dditsupport/solar_monitor/README.md

# Solar AC-Side Power Monitor

Single-phase AC-side monitoring for a 3.3 kW rooftop solar installation. The
device measures inverter output with a PZEM-004T v3.0, displays live metrics
on a local OLED, buffers 15-minute readings to internal flash, and mirrors
them to a MilesWeb-hosted PHP/MySQL backend via two store-and-forward paths:

- **Wi-Fi** — when a known hotspot is in range, the ESP32 connects, NTP-syncs,
  POSTs buffered rows, and clears them on server ACK.
- **BLE** — a companion Android app pulls buffered rows over GATT and
  forwards them to the same MilesWeb endpoint over the phone's cellular
  data.

The ESP32 is the source of truth. Cloud and app are catch-up mirrors.

## Repository layout

```
firmware/                 ESP32 firmware — three Arduino sketch variants
                          (see "Firmware variants" below)
backend/                  MilesWeb PHP + MySQL (planned, not yet built)
android/                  Companion app (planned, not yet built)
docs/                     Wiring, provisioning, future hardware notes
tools/                    Bench-test helpers (fake_ingest.py)
```

## How fast does data reach the cloud?

The firmware aims for **seconds, not minutes**, when Wi-Fi is reachable.
Once a 15-minute row is appended to flash, the sampling task immediately
asks the connectivity task to run a Wi-Fi cycle; the next 1-second tick
picks it up, connects, NTP-syncs, POSTs, and (on ACK) truncates the row
from flash. The 2-minute periodic scan still runs as a fallback for when
the AP is out of range.

If neither the RTC nor NTP gave the device a wall clock, the firmware
still POSTs (`sync_wall_time` is empty); MilesWeb is expected to return a
`server_time` ISO 8601 string in the response. The firmware uses that to
seed its clock and the RTC, so subsequent rows carry real timestamps.

## Status

This branch delivers **firmware Stages 1–7** per the project spec:

| Stage | Scope | Status |
|---|---|---|
| 1 | OLED bring-up | ✅ |
| 2 | PZEM bring-up | ✅ |
| 3 | PZEM + OLED integration | ✅ |
| 4 | LittleFS + NVS + boot history | ✅ |
| 5 | Backend (MilesWeb) | ⏳ next session |
| 6 | Wi-Fi sync end-to-end | ✅ (testable against `tools/fake_ingest.py`) |
| 7 | BLE GATT service | ✅ (testable with nRF Connect) |
| 8 | Android companion app | ⏳ next session |
| 9 | Backend dashboard | ⏳ next session |
| 10 | AC install | hardware, out of code scope |

## Building the firmware

See [`docs/PROVISIONING.md`](docs/PROVISIONING.md) for the full step-by-step.
Quick path:

1. Arduino IDE 2.x with libraries: U8g2, PZEM-004T-v30 (mandulaj),
   ArduinoJson, NimBLE-Arduino, RTClib. A known-good set of all five is
   vendored once at [`firmware/libraries.zip`](firmware/libraries.zip),
   shared by every sketch variant.
2. Board: **ESP32 Dev Module**, partition scheme:
   **No OTA (2MB APP/2MB SPIFFS)** — the build is ~1.5 MB and overflows the
   1.2 MB slot of the default scheme.
3. Open the `.ino` for the variant matching your hardware and Upload.

### Firmware variants

Pick the sketch folder that matches the board you built:

| Variant | Sketch folder | Display | RTC |
|---|---|---|---|
| OLED + DS3231 | `firmware/solar_monitor_SSD1306_ds3231/` | SSD1306 | DS3231 |
| OLED + DS1307 | `firmware/solar_monitor_SSD1306_ds1307/` | SSD1306 | DS1307 |
| Headless + DS1307 | `firmware/solar_monitor_ds1307/` | none | DS1307 |

They share every module except the RTC driver and the display; the two OLED
builds are pin-compatible with each other, while the headless build moves I²C
onto the pins the OLED would use. See [`docs/PINOUT.md`](docs/PINOUT.md).

## Bench-testing without a backend

Run the stub:

```bash
python3 tools/fake_ingest.py --port 8080
```

Point `INGEST_HOST_DEFAULT` in your variant's `firmware/<sketch>/config.h` at
`http://<laptop-ip>:8080/ingest`, reflash, and the device will exercise its
full sync path against the stub.

## Architecture quick reference

- **Two FreeRTOS tasks** pinned to separate cores:
  - Core 0 — sampling: 1 Hz PZEM read + OLED render. Every 15 min appends
    one row to `/log.csv` and advances `last_seq`.
  - Core 1 — connectivity: BLE GATT always advertising. Every 2 min
    attempts the Wi-Fi cycle (scan → connect → NTP → POST → ACK truncate).
- **Single mutex** protects the small shared-state POD; readers snapshot
  a value copy and release before doing any I/O.
- **Monotonic-µs clock** for energy integration (`esp_timer_get_time()`);
  wall-clock is only used for log timestamps and midnight rollover.
- **RTC** (DS3231 or DS1307, depending on variant) on I²C seeds wall-clock
  at boot so "Today: X kWh" is right immediately. NTP corrections are written
  back to the chip so it stays accurate across power loss. If the chip is
  absent or reports lost-power/halted, NTP and BLE Set-Wall-Time still work as
  before. I²C pins differ per variant — see [`docs/PINOUT.md`](docs/PINOUT.md).
- **NVS** uses two namespaces (`cfg` for Wi-Fi credentials, `state` for
  boot id / seq HWM / boot history) and a high-water-mark scheme that
  persists every 10 seqs to limit flash wear at the cost of small
  monotonic gaps across crashes.
- **`/log.csv`** is append-only with crash recovery on boot (deletes any
  leftover `/log.tmp`, validates and trims the last line). Sync uses
  snapshot-and-rewrite: capture max seq from RAM, send rows ≤ that, on
  ACK rewrite the file keeping only rows > that.
- **Buffer full**: when LittleFS free space drops below max(150 KB, 10 %),
  the firmware stops logging and surfaces "BUFFER FULL" on the OLED.

BLE access is gated by an HMAC-SHA256 challenge-response over a pre-shared key
(never sent over the air) — see [`docs/PROVISIONING.md`](docs/PROVISIONING.md)
§3a. Remaining security TODOs (no BLE link encryption, no cert pinning, no
HMAC payload signing on the Wi-Fi POST) are deferred to future hardening.
