dditsupport/solar_monitor/backend/README.md

# Backend (MilesWeb PHP 8.4 + MySQL)

Server-side counterpart to the ESP32 firmware. Multi-device, multi-user
with admin role.

## Host requirements

- **PHP 8.4** (8.2 minimum — `_db.php` exits early below that). Verified
  on 8.4; uses `Random\Randomizer`, `#[\SensitiveParameter]`,
  `JSON_THROW_ON_ERROR`, `match`, `?type`, `never` return, strict types.
- **MySQL 5.7+ or MariaDB 10.3+** (needs `JSON`-free schema and
  `ON DUPLICATE KEY UPDATE` — both old enough).
- **PDO_MYSQL** extension (default on MilesWeb / any cPanel host).
- **`mod_authz_core`** (for the `Require all denied` in `_config/.htaccess`).
  Standard on every Apache 2.4 install.
- **Let's Encrypt / Cloudflare TLS** for the public hostname so the
  ESP32's `WiFiClientSecure::setInsecure()` POST works (we accept any
  cert but still need *some* cert).

No Composer dependencies. No build step. No PHP frameworks.

## Layout

```
backend/
├── schema.sql                       ← one-time SQL setup
└── public_html/                     ← docroot of the solar.aromen.biz subdomain
    ├── _config/
    │   ├── .htaccess                ← Require all denied
    │   ├── secrets.php.example      ← copy to secrets.php, fill in
    │   └── secrets.php              ← gitignored; real creds live here
    ├── api/
    │   ├── _db.php                  ← PDO + auth + helpers
    │   ├── ingest.php               ← device POST endpoint (X-Device-Token)
    │   ├── readings.php             ← GET data for dashboard (session auth)
    │   ├── devices.php              ← list user's devices
    │   ├── login.php                ← POST login (form or JSON)
    │   ├── logout.php
    │   ├── admin_users.php          ← admin user CRUD
    │   └── admin_devices.php        ← admin device CRUD + binding
    ├── dashboard/
    │   ├── login.php                ← sign-in page
    │   ├── index.php                ← user dashboard with charts
    │   └── assets/style.css
    └── admin/
        ├── index.php                ← admin overview + recent ingest log
        ├── users.php                ← create / edit / delete users
        └── devices.php              ← assign devices to users
```

## Deploy

1. **Database** — create a MySQL DB and user in cPanel:
   ```text
   db name:  <prefix>_solar
   db user:  <prefix>_solarapp     (grant ALL on the db)
   ```
   Then in phpMyAdmin → SQL tab, paste the contents of `schema.sql` and run.

2. **Secrets** — copy `public_html/_config/secrets.php.example` to
   `public_html/_config/secrets.php` and fill in DB creds + token.
   The `DEVICE_TOKEN` value must match `DEVICE_TOKEN` in the `config.h` of
   whichever firmware variant you flashed (all sketch folders under
   `firmware/` must carry the same token).

3. **Upload** — drop the contents of `public_html/` into the **solar.aromen.biz**
   subdomain's document root (so the URLs end up at e.g.
   `https://solar.aromen.biz/...`, with no `/solar` path prefix).

4. **Verify .htaccess works** — visit
   `https://solar.aromen.biz/_config/secrets.php` in a browser. Should return
   403. If it serves the file, your host doesn't honor `Require all denied` —
   move `_config/` outside the docroot and adjust `require_once` paths
   in `api/_db.php`.

5. **First admin login** — visit
   `https://solar.aromen.biz/bootstrap.php`. The page creates the
   first admin account from a form, then locks itself the moment any
   admin row exists. Sign in at `/dashboard/login.php` afterwards
   and (optionally) delete `bootstrap.php` from the server.

6. **Point a device** — confirm `INGEST_HOST_DEFAULT` (firmware
   `config.h`) is `https://solar.aromen.biz` or push a different value via
   BLE. Power on the ESP32; within ~30 s its heartbeat POST lands and
   the device auto-registers. Then Admin → Devices to bind it to a user.

## Routes

### Device-facing

| Method | URL | Auth | Purpose |
|---|---|---|---|
| POST | `/api/ingest.php` | `X-Device-Token` | data ingest |

Request shape: per spec §3.5, plus `Hz` per reading. Response:

```json
{
  "ok": true,
  "acked_up_to_seq": 1248,
  "server_time": "2026-06-20T17:24:32+05:30",
  "log_interval_sec": 900
}
```

`log_interval_sec` is the effective cadence for the device — taken from
`device_meta.log_interval_sec` (per-device override), falling back to
`DEFAULT_LOG_INTERVAL_SEC` from `secrets.php`.

### Browser / Android app

All require a session cookie (`solar_sess`) from POST `/api/login.php`.

| Method | URL | Auth | Purpose |
|---|---|---|---|
| POST | `/api/login.php` | none | `{username,password}` → session |
| GET/POST | `/api/logout.php` | any | clear session |
| GET | `/api/devices.php` | session | list devices user can see |
| GET | `/api/readings.php` | session | data points; query params: `device_id`, `from`, `to`, `aggregate=raw\|hourly\|daily\|monthly` |
| POST | `/api/admin_users.php` | admin | `action=list\|create\|set_password\|set_admin\|delete` (CSRF) |
| POST | `/api/admin_devices.php` | admin | `action=list\|bind\|rename\|set_interval\|delete` (CSRF) |

### Pages

| URL | Auth | Purpose |
|---|---|---|
| `/dashboard/login.php` | none | sign-in form |
| `/dashboard/` | session | charts: Today / 7 d / 30 d / 12 mo / custom From-To range |
| `/admin/` | admin | overview + recent ingest activity |
| `/admin/users.php` | admin | user CRUD |
| `/admin/devices.php` | admin | device binding + per-device interval override |

## Aggregations

`readings.php?aggregate=hourly|daily|monthly` groups rows by bucket and
computes energy generated in the bucket from the PZEM's monotonically
increasing `Wh` counter. Buckets **telescope**: each one spans from its own
first reading to the *next* bucket's first reading (the last one runs to the
window's highest reading), so the buckets sum exactly to `total_kwh` —
`MAX(energy_wh) - MIN(energy_wh)` over the whole window — and nothing is lost
in the gaps between buckets.

**Counter resets.** The PZEM's counter restarts at 0 on the app's "Reset
PZEM" command or a PZEM swap, and rolls over at 9,999.99 kWh. `ingest.php`
records every drop between two readings adjacent in `seq` order in
`energy_resets` (migration 009), and `readings.php` adds each drop's
`wh_before` back onto every later reading, so all of the above runs on one
unbroken counter. Devices with data from before migration 009 are scanned once,
the first time their readings are requested.

**Reading numbers (`seq`).** `(device_id, seq)` is unique and duplicates are
ignored, so a re-sent batch is harmless. A device whose counter restarts at 1
(full flash erase, factory reset, a new board under the same `device_id`) would
otherwise have every new row silently dropped and still acked. So the device
sends `seq_fresh: true` until its counter has been lined up, and `ingest.php`
also checks whether any seq in the batch is already stored for a *different*
reading (another boot / uptime; an exact re-send matches). In either case it
stores nothing and answers `{"ok": false, "error": "seq_base_required",
"seq_base": N}` with N = the highest seq it holds. The device adds N to every
buffered row and to its counter and sends again; the Android relay passes N to
the device with the `{"cmd":"seq_base","base":N}` BLE command and re-syncs.

**Row timestamps.** The firmware stamps each row with its RTC/NTP epoch (`t`)
when the clock is known. Rows from the current boot are still placed by uptime
offset from `sync_wall_time` (exact, and it corrects an RTC that was off when
the row was logged); rows from earlier boots use `t`, because the boot chain
cannot see how long the device was powered off between boots.

The response also carries `meter_wh` / `meter_at`: the device's newest
cumulative reading and when it was logged, ignoring the requested window
entirely. `total_kwh` is always a difference (what was generated inside the
window); `meter_wh` is the running total. The dashboard keeps them in
separate cards — "Period total" and "Meter reading" — so a range can never
read like a lifetime figure.

Each point carries the two meter readings its energy is the difference of,
`wh_start` and `wh_end` (Wh, `wh_end - wh_start == kwh * 1000`); the dashboard
prints them under the chart. Consecutive buckets share a reading — one
bucket's `wh_end` is the next one's `wh_start`. Also returns `P_avg`,
`P_peak`, `V_avg`, `samples`, and `approx` (true if any rows in the
bucket had `time_confidence='approx'`).

## Heartbeat POSTs

Devices POST every ~hour even with no readings, so the server can push
fresh `log_interval_sec` / `server_time` to idle devices. Heartbeat
requests look identical to data requests but have an empty
`readings: []` array. The endpoint treats them as ordinary POSTs;
`acked_up_to_seq` will be 0.

## Security TODO list

- [ ] Replace `setInsecure()` cert pinning on the firmware side
- [ ] HMAC-sign device payloads to prevent token replay over hostile Wi-Fi
- [ ] Rate-limit `/api/login.php` per source IP
- [ ] HTTPS everywhere (rely on host-supplied Let's Encrypt cert)
- [ ] Bonding on BLE before opening Wi-Fi credential characteristic
