dditsupport/solar_monitor/(list of files, drawings)

Other design files:
hardware/solar_monitor.dip
