dditsupport/solar_monitor/firmware/solar_monitor_SSD1306_ds1307/identity.h

#pragma once

#include <Arduino.h>

namespace identity {

// "solar-a3f29c" (last 6 of MAC, lowercase). Cached after first call.
const String &device_id();

// "Solar-A3F29C" (uppercase). Used for BLE advertising name.
const String &ble_name();

// FW_VERSION from config.h
const char *fw_version();

}  // namespace identity
