dditsupport/solar_monitor/(commit log)

2026-05-19 Add ESP32 firmware (stages 1-7) and project scaffolding
    Initial monorepo scaffold for the solar AC-side power monitor. This commit
    delivers firmware stages 1-7 of the spec: OLED bring-up, PZEM reads,
    integrated 1Hz sampling+display, LittleFS+NVS logging with boot chain,
    Wi-Fi sync to a backend, and BLE GATT service. Backend and Android app
    are stubbed-out placeholders to be filled in next session.
    Firmware highlights:
    - Two pinned FreeRTOS tasks: sampling/display on core 0, BLE+Wi-Fi sync
    on core 1. One mutex guards a small POD SharedState; readers snapshot
    and release before doing any I/O.
    - Monotonic esp_timer_get_time() drives energy integration so wall-clock
    jumps from NTP/BLE nev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
2026-06-07 Single-credential Wi-Fi, immediate connect, and BLE-driven scan
    Three companion-app-driven changes on top of the BLE provisioning flow:
    - MAX_WIFI_CREDS=1: the firmware now stores exactly one Wi-Fi
    credential. add_wifi_cred() always overwrites the prior entry.
    - Connect immediately after save: BLE write of {"ssid","password"}
    now triggers wifi_sync::request_immediate_sync(), which the
    ConnectivityTask consumes on its next 1Hz tick. No more waiting up
    to two minutes for the periodic scan. Wi-Fi Status is upgraded to
    READ+NOTIFY so the app sees saved -> scanning -> connecting ->
    connected -> syncing -> idle without polling.
    - BLE-driven Wi-Fi scan: writing {"action":"scan"} to W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
2026-06-07 Integrate DS3231 RTC for boot-time wall clock
    The DS3231 (added during hardware bring-up after the original spec)
    gives the device a battery-backed wall clock so the OLED can show
    "Today: X kWh" the moment it powers on instead of waiting for NTP or
    the companion app.
    - rtc.{h,cpp}: thin RTClib wrapper. begin() probes the chip, checks
    the lost-power (OSF) bit, and refuses to trust a stale reading.
    - Boot path: after storage and PZEM come up, the firmware reads the
    RTC and seeds time_source::set_wall_clock() if the chip is healthy.
    - Wi-Fi sync path: after NTP succeeds, the corrected epoch is written
    back to the DS3231 (skipped if drift is under
    RTC_WRITEBACK_DRIFT_SEC) so the chip st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
    [ble_service.cpp, config.h, rtc.cpp, rtc.h, wifi_sync.cpp]
2026-06-08 Final pinout: move OLED RST off strapping pin, document silkscreen labels
    - OLED RST: GPIO 2 -> GPIO 19. GPIO 2 is a boot strapping pin (must be
    LOW or floating at power-on) and is wired to the on-board LED on most
    DevKit boards. GPIO 19 is on the same right-side cluster as the rest
    of the OLED lines and is not a strapping pin.
    - docs/PINOUT.md: rewritten with a definitive table that includes the
    silkscreen labels, physical side, and approximate position number for
    every connection, plus an ASCII pin layout, strapping-pin notes, and a
    list of free pins for future expansion.
2026-06-08 Clean up PINOUT.md silkscreen table and ASCII diagram
    - Drop the misleading "Position (from top)" column from the pin table
    (positions vary across 30-pin DevKit variants; the silkscreen label
    is the only reliable identifier) and add a short note that the
    Silkscreen column is what to look at when soldering.
    - Rewrite the ASCII pin diagram with correct positions: the prior
    version had two right-side rows numbered (7) and a confused label.
    D19 is at right-column position 8, not 7.
    - Mark unused pins explicitly as "free" rather than leaving the reader
    to infer.
2026-06-09 Immediate sync after row write, server_time fallback for wall clock
    Two changes tightening the cloud-side feedback loop:
    - Immediate sync after each 15-min row: SamplingTask now calls
    wifi_sync::request_immediate_sync() right after a successful
    append_row(). On the next 1s ConnectivityTask tick, the device runs
    a full scan -> connect -> NTP -> POST cycle, so the row reaches
    MilesWeb within seconds instead of waiting up to two minutes for the
    periodic scan. The 2-min periodic cycle stays as a fallback for
    AP-out-of-range.
    - server_time fallback: the firmware now reads an optional
    server_time ISO 8601 string from the ingest response. If neither the
    DS3231 nor NTP gave the dev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
    [wifi_sync.cpp]
2026-06-09 Android app scaffold: BLE scan, add/remove saved devices
    First slice of stage 8. Kotlin + Jetpack Compose project under
    android/solar-monitor-app/. Opens to a "My devices" screen showing the
    user's saved list; the search FAB opens "Nearby" which scans for BLE
    advertisements carrying the firmware's custom service UUID
    (5f12b3bc-8ef3-4b48-a971-f70a38f519ec). Discovered devices stream into
    a list as they appear; tap Add to save, tap the trash icon on the saved
    screen to remove.
    Build / persistence choices:
    - Gradle Kotlin DSL with a version catalog (gradle/libs.versions.toml)
    pinned to AGP 8.7.3, Kotlin 2.1.0, Compose BOM 2025.01.00.
    - DataStore Preferences holds the saved-device list as a s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
2026-06-09 PINOUT.md: match user's actual board silkscreen + confirmed chip specs
    The user's clearer board photo plus esptool chip_id output revealed two
    documentation gaps:
    - PZEM pins: this board's silkscreen labels GPIO 16/17 as RX2/TX2 (not
    D16/D17 as I had assumed from the generic DOIT layout). Updated the
    pin map and visual diagram so the silkscreen column matches what the
    user actually sees while soldering.
    - Power and GND positions are flipped vs. the layout I documented. On
    this board EN is top-left, 3V3 is bottom-right, VIN is bottom-left,
    GND pins are near the bottom of both columns. The visual diagram has
    been redrawn to match.
    Also added a "Confirmed hardware" section record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
2026-06-11 Target ESP32 Arduino core 3.3.10 (NimBLE 2.x, esp_task_wdt 5.x)
    The user is on Arduino IDE 2.3.10 with ESP32 by Espressif core 3.3.10
    (ESP-IDF 5.x). Three API breaks vs. core 2.x needed to land:
    - NimBLE-Arduino 2.x callbacks: ServerCallbacks::onConnect /
    onDisconnect / onMTUChange, and CharacteristicCallbacks::onWrite /
    onSubscribe now take NimBLEConnInfo& instead of ble_gap_conn_desc*.
    Updated all five callback classes (ServerCallbacks, SetTimeCallbacks,
    StreamCallbacks, AckCallbacks, WifiCfgCallbacks).
    - NimBLEDevice::setPower now takes int dBm directly; replaced the old
    ESP_PWR_LVL_P3 enum with a literal +3 dBm.
    - esp_task_wdt_init(timeout_sec, panic) was replaced by an
    esp_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
    [ble_service.cpp, health.cpp]
2026-06-11 Fix two core 3.x build errors: PZEM constructor, NimBLE 2.x advert
    - pzem::begin(): the mandulaj PZEM004Tv30 1.1.x constructor signature
    is (HardwareSerial&, rxPin, txPin, addr=default), not the single-arg
    form I had originally. The library also runs Serial.begin() inside
    the constructor, so the manual pzemSerial.begin() and HardwareSerial
    instance are redundant. Switched to Serial2 with explicit pins.
    - ble_service::begin(): NimBLEAdvertising::setScanResponse(bool) was
    renamed to enableScanResponse(bool) in NimBLE-Arduino 2.x. The
    similarly-named setScanResponseData() takes an advertisement-data
    object and is unrelated to enabling the scan-response packet itself.
    [ble_service.cpp, pzem.cpp]
2026-06-11 PROVISIONING.md: bump partition to No OTA (2MB APP/2MB SPIFFS)
    The default "4MB with spiffs (1.2MB APP/1.5MB SPIFFS)" partition no
    longer fits the binary — at ~1.5 MB after the NimBLE 2.x + ArduinoJson
    7 + RTC + Wi-Fi scan additions, it overflows the 1.2 MB APP slot.
    Switched to the built-in "No OTA (2MB APP/2MB SPIFFS)" scheme, which
    both fits the binary with headroom and bumps the LittleFS partition
    from 1.5 MB to 2 MB. Log capacity improves accordingly: the 200 KB
    buffer-full threshold (10% of 2 MB) still leaves >9 months of 15-min
    rows.
2026-06-11 PINOUT.md: switch back to 38-pin ESP-WROOM-32D layout
    The user's 30-pin board had hardware issues (write-timeout during
    flash upload). Switching back to the original 38-pin ESP-WROOM-32D
    DevKit V1. Firmware GPIO assignments are unchanged so no code touches
    needed; only the silkscreen labels and physical pin positions move:
    - Silkscreen labels are plain numerical (16, 17, 18, ...) instead of
    the 30-pin board's RX2/TX2 mnemonics. PZEM TX still goes to GPIO 16,
    PZEM RX still goes to GPIO 17.
    - 3V3 is back at TOP-LEFT (rather than bottom-right). VIN/5V is at
    BOTTOM-LEFT, just past the SD-flash sub-row. GND has several
    positions on both columns.
    - Visual diagram redrawn with the SD-flash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
2026-06-13 Pin swap: DS3231 on 22/23, OLED MOSI moves to 21
    User requested DS3231 SDA=GPIO 22, SCL=GPIO 23. GPIO 23 was OLED MOSI,
    so the three-pin rotation lands as:
    - DS3231 SDA: 21 -> 22
    - DS3231 SCL: 22 -> 23
    - OLED MOSI: 23 -> 21 (takes the freed pin)
    All three signals stay on the right column, no strapping pins involved.
    display.cpp had to switch from U8G2_..._F_4W_HW_SPI to the _SW_SPI
    variant: the HW SPI constructor uses VSPI defaults (MOSI=23), but we
    now drive MOSI on GPIO 21. SW SPI bit-bangs at >1 MHz on a 240 MHz
    ESP32, which refreshes the 1 KB framebuffer at 1 Hz with cycles to
    spare.
    PINOUT.md table and ASCII diagram updated to match.
    [config.h, display.cpp]
2026-06-17 Optional WIFI_SSID/WIFI_PASSWORD bench-test fallback in config.h
    Bench testing without the companion app needed a way to get the device
    on Wi-Fi other than connecting nRF Connect every time. Added two
    optional macros (both empty by default) in config.h. If WIFI_SSID is
    non-empty AND the NVS slot has no credentials yet, setup() copies them
    into NVS before tasks spawn. Once the user provisions via BLE the saved
    value takes over and the seeding becomes a no-op.
    Empty values preserve the production flow: BLE-only provisioning, no
    secrets in flash.
2026-06-17 Add SYNC and LOG serial commands for end-to-end POST testing
    The first real log row only happens at boot+LOG_INTERVAL_SEC (15 min),
    which is slow when bench-testing the ingest.php round-trip. Two new
    serial commands shortcut that wait:
    - SYNC: calls wifi_sync::request_immediate_sync() so the next
    ConnectivityTask tick runs a full scan -> connect -> NTP -> POST
    cycle. Pure no-op if there's nothing buffered.
    - LOG: appends a synthetic row built from the current PZEM snapshot
    (V/I/P/Wh/PF), advances last_seq, and requests immediate sync.
    Lets the user verify the full path (NVS HWM advance, file append,
    POST, ack-truncate) without waiting for the natural cadence.
    Help line updated.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
2026-06-17 Optional PZEM_DEMO_MODE for bench testing without the PZEM wired
    The user is seeing "PZEM ERROR" because the PZEM hardware isn't
    connected during early bench work. Added a compile-time switch in
    config.h (PZEM_DEMO_MODE, default 0) that bypasses Modbus entirely and
    feeds the rest of the firmware synthetic-but-plausible readings:
    V = 230 V ± 1.5 V
    I = 0.5 .. 7.5 A sine wave
    P = V * I
    Wh = integrating power over time
    PF = 0.98, freq = 50 Hz
    Lets the OLED render real-looking values, the 15-min logger append
    plausible rows, the Wi-Fi sync exercise the POST path, and the BLE data
    stream emit usable test data. Flip to 0 once the PZEM is physically
    wired up.
    Implemented behind #if PZE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
    [config.h, pzem.cpp]
2026-06-18 Prune boot_history: skip zero-duration boots, auto-trim after ACK
    The user's first server-side inbox.log showed ~18 boot_history entries,
    most with duration_sec: 0. Those are development reflashes that never
    ran long enough to log a single row, so they carry no readings and just
    clutter every sync payload. Three changes to clean it up:
    1. storage::begin(): don't push_boot_record() when the previous boot
    had zero duration. Zero-duration boots produce no rows, so the
    server has nothing to timestamp from them.
    2. storage::prune_boot_history_below(min_keep_boot_id): drop entries
    whose boot_id is lower than the oldest remaining row's boot_id.
    wifi_sync::run_cycle() calls this right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
    [config.h, storage.cpp, storage.h, wifi_sync.cpp]
2026-06-18 Show RTC wall time on OLED (DD-HH:MM) and on boot serial
    OLED: top-right corner now shows the local wall clock as DD-HH:MM
    (e.g. "18-17:24" for June 18 at 5:24 PM IST). Only rendered when
    wall_clock_known is true; positioned right-aligned at y=8 so it sits
    beside the big power digits without colliding even at the 3.3 kW
    peak (max ~80 px wide on the left).
    Boot serial: rtc::begin() success path now formats the seeded epoch
    into a human-readable line:
    [boot] RTC time: 2026-06-18 17:24:32 IST (epoch=1750264472)
    The lost-power / unavailable branches also log a clear line so the
    user can tell at a glance whether the RTC was usable. The OLED still
    falls back to "Session: X kWh" when wall_clo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
    [display.cpp]
2026-06-18 display.cpp: add missing time_source.h include (dropped in 05453ee)
    [display.cpp]
2026-06-18 PZEM is source of truth for all OLED kWh; add Total line; uniform power font
    Drop the ESP32-side energy integration entirely. All three kWh values on
    the OLED now come from the PZEM's own cumulative counter:
    - total_kwh = PZEM Wh / 1000 (PZEM lifetime)
    - today_kwh = (PZEM Wh - today_anchor_wh) / 1000 (today)
    - session_kwh = (PZEM Wh - session_anchor_wh) / 1000 (this boot)
    today_anchor_wh / day / clean live in NVS (storage::today_anchor_*),
    so the "today" reading survives any number of ESP32 reboots as long as
    the PZEM is alive: on each tick the firmware reads the cumulative Wh
    and subtracts the stored anchor. Re-anchor triggers:
    - no anchor exists (first boot e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
    [display.cpp, shared_state.h, storage.cpp, storage.h]
2026-06-19 Split INGEST_URL: path hardcoded, host BLE-settable like Wi-Fi creds
    User asked for the backend hostname to be runtime-configurable from the
    Android app — same operational pattern as Wi-Fi SSID/password — while
    keeping the path component fixed in firmware (/solar/api/ingest.php).
    Changes:
    - config.h: INGEST_URL is gone. Replaced by:
    INGEST_HOST_DEFAULT ("https://aromen.biz") default if NVS unset
    INGEST_PATH ("/solar/api/ingest.php") always firmware-fixed
    Plus a new BLE characteristic UUID BLE_UUID_SERVER_CONFIG.
    - storage::ingest_host() / set_ingest_host(): NVS-backed (cfg namespace,
    key "host"). Empty string means "use compiled default". Updates from
    the BLE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
    [ble_service.cpp, config.h, storage.cpp, storage.h, wifi_sync.cpp]
2026-06-20 LOG_INTERVAL_SEC fetched from server; falls back to compiled default
    User asked for the logging cadence to be server-controlled so ops can
    dial it up/down without reflashing the device.
    Mechanism:
    - Each ingest.php response may include {"log_interval_sec": N}. The
    firmware parses it in wifi_sync::post_batch() and persists to NVS
    via storage::set_log_interval_sec(). Values outside [60, 86400] are
    silently ignored (sanity-bounded by config.h LOG_INTERVAL_SEC_MIN/MAX).
    - sampling_task() reads storage::log_interval_sec() on every loop
    iteration instead of a compile-time constant, so the new cadence
    takes effect on the next tick after the response lands. No reboot
    required.
    - A no-o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
    [ble_service.cpp, config.h, storage.cpp, storage.h, wifi_sync.cpp]
2026-06-20 Heartbeat POSTs so log_interval_sec can be fetched while device is idle
    Before: log_interval_sec was only parsed out of POST responses, and
    post_batch() returned early when the buffer was empty. So a brand-new
    device with the default 15-min cadence would wait the full 15 minutes
    for its first row before learning the server's preferred cadence. And
    a long-running quiet device would never refresh its config at all.
    After: post_batch() forces a POST with an empty readings array when
    either (a) we've never had a successful POST this boot, or (b) more
    than CONFIG_HEARTBEAT_SEC seconds (default 3600) have passed since the
    last successful POST. The server gets the same JSON shape it always
    sees, j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
2026-06-20 Backend: multi-device, multi-user, admin device binding, charts
    Full PHP/MySQL server-side stack under backend/, deployable to MilesWeb
    or any shared host with PHP 8.4 + MySQL/MariaDB. The firmware already
    POSTs to this endpoint shape — this commit makes the server actually
    exist.
    Schema (backend/schema.sql):
    - users: username + bcrypt hash + is_admin flag
    - devices: auto-registered on first ingest, owner_user_id assigned
    later by an admin
    - device_meta: per-device fw_version, last_sync, log_interval_sec
    override
    - solar_readings: (device_id, seq) UNIQUE so duplicate POSTs are silent
    no-ops; indexed for (device_id, wall_time) range queries; includes
    the new frequency_hz column
    - i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
2026-06-20 Backend: PHP 8.4 idioms — SensitiveParameter, Randomizer, JSON_THROW
    User flagged PHP 8.4 explicitly. Audit pass — the code already used
    strict_types / never / match / nullable types / ?? / etc. — but added
    a handful of modern touches that PHP 8.2+ enables:
    - #[\SensitiveParameter] on every function that takes a password (PHP
    8.2+). Keeps the plaintext out of stack traces if any exception
    escapes — Throwable arg dumps redact tagged parameters. Refactored
    inline password-handling blocks in admin_users.php, login.php,
    dashboard/login.php, and bootstrap.php into small helpers so the
    attribute has something to attach to.
    - Random\Randomizer (PHP 8.2+) for the CSRF token instea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
2026-06-21 Android: BLE detail + cloud dashboard + provisioning flows
    App now scales beyond the discovery MVP: bottom-nav with Devices and Cloud
    sections, nested device-detail / Wi-Fi-config / server-config flows on top
    of a Kable-managed GATT connection, and a Ktor-backed dashboard that
    reads /solar/api/devices.php + /solar/api/readings.php and renders
    Vico column/line charts for the selected device and range.
    Notable pieces:
    - ble/SolarGatt.kt wraps every characteristic exposed by the firmware
    (DeviceInfo, BootHistory, DataStream, SyncAck, WifiConfig/Status/Scan,
    ServerConfig, SetWallTime). One Kable Peripheral per ViewModel, shared
    across the nested screens so we never open two BLE connection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
2026-06-21 Backend + Android: claim/register a device from the app
    Until now only admins could bind a device to a user (admin_devices.php).
    That left a hole in the provisioning story: a regular user who installs a
    new ESP32, connects to it over BLE from the Android app, and signs in to
    their cloud account had no way to put the device into their dashboard.
    Backend:
    - claim_device.php — POST { device_id, friendly_name?, location?,
    capacity_kw?, notes? }. Requires login + CSRF. Inserts the device row
    if missing and binds owner_user_id to the current user; if the device
    is already owned by someone else, returns 409 owned_by_other_user.
    Admins can still re-bind via the existing panel.
    - login.php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
2026-06-22 Android: pin Kable to 0.30.0
    Kable 0.32.0 didn't resolve from Maven Central in a fresh Android Studio
    sync. 0.30.0 is the most recent version I've confirmed mirrors universally
    and is API-compatible with the SolarGatt wrapper as written (Peripheral,
    characteristicOf, WriteType, observe()).
2026-06-22 Android: fix manifest xmlns:tools scope + bump Kable to a real version
    Manifest: tools:targetApi="s" was on <uses-permission> at line 18, but
    xmlns:tools was declared on <application> (line 32). XML namespaces don't
    flow up to siblings, so AAPT rejected the file with AttributePrefixUnbound.
    Dropping the tools: hints entirely — they were lint-only and never
    affected runtime behavior.
    Kable: com.juul.kable:kable-core's first published version on Maven Central
    is 0.33.0; the 0.30.0 / 0.32.0 I picked earlier never existed under that
    artifact name. 0.35.0 is the newest version still compatible with our
    Kotlin 2.1.0 (0.36+ require Kotlin 2.1.10+). API surface used by SolarGatt
    is unchanged.
2026-06-23 Android: clear Kable 0.35 + Material3 deprecation warnings
    - SolarGatt: switch to top-level Peripheral(identifier) builder. Kable
    0.35 owns the internal coroutine scope; the scope-extension form is
    deprecated. Lifecycle is now driven purely by connect()/disconnect().
    - DeviceDetailViewModel: replace ConnectionLostException with
    NotConnectedException (the typealias is deprecated; all connection-
    loss cases are folded into one exception class).
    - CloudDashboardScreen: use the menuAnchor(MenuAnchorType, enabled)
    overload required by Material3 1.3+; the zero-arg form is deprecated.
    - ScanScreen: switch the back-arrow icon to the AutoMirrored version
    so it flips correctly in RTL local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
2026-06-23 Android: use MenuAnchorType, not ExposedDropdownMenuAnchorType
    The Material3 1.3.x menuAnchor overload takes MenuAnchorType; the
    ExposedDropdownMenuAnchorType name only exists in much newer Material3
    betas not present in Compose BOM 2025.01.00.
2026-06-23 Admin: arrange devices table into proper columns
    Editable metadata used to share a single cell with no width hints, so the
    three inputs (name / location / kW) wrapped vertically and the Save button
    ended up two rows below the field it saves. Now each editable field is in
    its own column, log interval has its own column with the Set button inline,
    read-only meta (last sync / FW / rows) is grouped to the right, and the
    row actions (Save / view / Delete) sit together at the end.
2026-06-23 Backend: rename SQL table devices -> energy_devices
    Schema, all read/write queries (api/_db.php, api/devices.php,
    api/admin_devices.php, api/claim_device.php, api/ingest.php,
    api/readings.php, api/admin_users.php, admin/devices.php,
    admin/index.php, admin/users.php, dashboard/index.php), and FK
    references in device_meta and solar_readings now point at
    energy_devices.
    Variable names (\$devices), JSON response keys ('devices' => ...),
    file paths (/solar/api/devices.php), and CSS classes are unchanged
    so the public API contract and the Android app are unaffected.
    migrations/001_rename_devices_to_energy_devices.sql: idempotent
    RENAME TABLE for live databases. InnoDB auto-updates the foreign
    ke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
2026-06-23 Android: Wi-Fi screen — always-visible manual SSID/password entry
    The previous flow forced the user to pick an SSID from the firmware's
    scan list before the credential fields would even appear. If the device
    returned an empty scan (or the notify never fired), the user was stuck
    on a blank "Scanning…" screen with no way to type in their network name.
    Now: SSID + password fields are at the top and always editable. The
    scan list below is a convenience that pre-fills the SSID when a row is
    tapped. An initial scan still fires automatically when the screen opens
    so the list will appear if the device cooperates.
2026-06-23 Dashboard: load Chart.js date adapter; visible range buttons; /solar/ entry
    Charts and stat cards came up empty because Chart.js 4 needs an explicit
    date adapter for type:'time' axes. Without it the chart constructor throws
    and the surrounding stats end up wiped too. Added chartjs-adapter-date-fns
    and wrapped loadLive() in per-fetch try/catch so a single bad response
    falls back to '—' instead of nuking both stats.
    .range-buttons button used to override the base button background to white
    but inherit the base white text color, so every range except 'Today' (which
    gets a slightly darker .on background) was invisible. Set color: var(--text)
    on the base state and color: var(--primary) on hove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
2026-06-23 Dashboard: cache-bust stylesheet (?v=2)
    The repo-side CSS already gives .range-buttons button an explicit
    color: var(--text), but browsers were still rendering the cached
    white-on-white version. Bumping the asset version on every page
    that links the stylesheet forces a fresh fetch so the rule actually
    takes effect without users hard-refreshing.
2026-06-23 Backend UI: legible admin table inputs + mobile-responsive layout
    Admin -> devices: inputs were squeezed to ~6 chars wide because 10
    table columns shared the .card width. Set min-widths per field
    (name 9rem, location 8rem, owner 8rem, kw 5rem, interval 5.5rem),
    gave the table a 920px min-width, and marked its parent .card as
    .scroll-x so it scrolls horizontally on narrow viewports instead of
    clipping. Text now fits without truncation.
    Stylesheet now has a @media (max-width: 640px) block that:
    - stacks the topbar (brand on one line, links on next)
    - collapses the .controls row vertically and full-widths the
    device-picker and range buttons
    - drops the stats grid to a 2-column layout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
2026-06-23 Dashboard: Today fixed to 7am-7pm; per-range x-axis tick unit
    For the Today range only, force the chart x-axis to 7am-7pm of the
    current day. Solar dashboards benefit from a consistent daylight
    window — partial data shows up in the right place instead of
    stretching across whatever fraction of the day has been logged.
    Other ranges still auto-fit to the data, but now pass an explicit
    time unit so Chart.js doesn't generate five-minute ticks when only
    a couple of hourly buckets exist (which was the cause of the
    'every 5 minutes from 10am to 1pm' tick spam).
    CSS cache key bumped to v=4.
2026-06-23 Firmware: mutex-guarded Serial logging + hourly NTP
    Two FreeRTOS tasks (sampling on core 0, connectivity on core 1) write
    to Serial concurrently. Serial.printf() on ESP32 is not atomic, so the
    UART byte stream interleaves and the long "[wifi] connected to <ssid>"
    line regularly came out with its prefix replaced by high-bit garbage
    that the terminal renders as '����������'.
    log_serial.{h,cpp} owns a FreeRTOS mutex and exposes LOG_PRINTF /
    LOG_PRINTLN / LOG_PRINT / LOG_WRITE macros that take and release the
    mutex around the underlying Serial call. Every Serial.printf/println/
    print/write across wifi_sync, ble_service, rtc, storage, health, pzem,
    and the .ino sketch (62 cal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
    [ble_service.cpp, config.h, health.cpp, log_serial.cpp, log_serial.h, pzem.cpp, rtc.cpp, storage.cpp]
2026-06-23 Firmware: route ESP-IDF logs through the Serial mutex
    The mutex caught our own Serial.* calls but not esp_log_write(), which
    the IDF wifi / lwip / NimBLE drivers use directly. On every Wi-Fi
    reconnect the IDF emitted internal 'wifi: STA ...' chatter at the same
    instant our '[wifi] connected to ...' line printed, and the two writes
    interleaved on UART — the prefix of our line got clobbered with the
    IDF's high-bit bytes and rendered as '����������nd_Floor'.
    log_serial::init() now:
    - Lowers the noisy WARN/INFO tags from wifi / dhcpc / lwip / NimBLE /
    HTTPClient to WARN, so most of the chatter is silenced outright.
    - Registers a locked_vprintf hook via esp_log_set_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
2026-06-23 Dashboard: show last sync time under the device picker
    Surfaces device_meta.last_sync_at for the currently-selected device as
    'Last sync: 2026-06-23 12:38:28 (3 min ago)'. The absolute timestamp
    comes from the SQL row already returned by the existing devices query,
    and a small JS interval rewrites the relative span every 30 s so the
    'X min ago' label stays fresh without a page reload. Shows 'never' if
    the device has been registered but hasn't POSTed yet.
    CSS cache key bumped to v=5.
2026-06-23 Dashboard: move 'Last sync' inline, after the range buttons
2026-06-23 Firmware: stuck-Wi-Fi (6 h) and stuck-BLE (12 h) soft-reboot watchdogs
    The 30 s task WDT catches frozen tasks but not the failure mode where
    every task keeps running yet the radio side is silently dead — Wi-Fi
    driver enters a wedged state and re-connects never succeed, or NimBLE
    stops advertising while our tick() returns instantly. Two new soft
    watchdogs in the connectivity task close that gap.
    Stuck-Wi-Fi: wifi_sync now records the monotonic timestamp of every
    successful ingest POST and exposes seconds_since_last_successful_post().
    The connectivity task reboots via esp_restart() when that exceeds
    STUCK_WIFI_REBOOT_SEC (21600 = 6 h). A brand-new device that has never
    posted is exempt —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
    [ble_service.cpp, ble_service.h, config.h, wifi_sync.cpp, wifi_sync.h]
2026-06-23 Firmware: reuse existing Wi-Fi link across cycles
    try_connect_known() ran scanNetworks + WiFi.begin every wifi cycle,
    even when the link was already up. That forced a disconnect/reconnect
    every 2 minutes, which:
    - Spammed the log with '[wifi] connected to ...' on every cycle.
    - Caused the ESP-IDF wifi driver to emit early-log diagnostic
    bursts via ets_printf — these go straight to the ROM UART
    routines and bypass our locked_vprintf hook, so they were the
    last source of '���' garbage interleaved with our own lines.
    Now we early-return on WL_CONNECTED. Subsequent cycles go straight to
    NTP-if-due / post_batch with no radio churn.
2026-06-23 Firmware: read MAC from eFuse, not WiFi.macAddress(), for device_id
    The diagnostic in the previous commit confirmed it: the chip's real
    eFuse + STA MAC is 8C:94:DF:47:5B:78, but identity::device_id() was
    producing 'solar-001e00'. The bytes 00:1E:00 are stack garbage left
    in the local mac[6] buffer.
    identity::compute() runs during the first device_id() call, which on
    this firmware happens in setup() before WiFi has ever been initialised.
    Arduino-ESP32 3.x's WiFi.macAddress(uint8_t*) routes through a netif
    shortcut that returns the buffer unchanged when the netif hasn't been
    created yet — it does NOT silently fall back to esp_read_mac like 2.x
    did. Result: garbage.
    Fix: bypass the WiFi wra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
    [identity.cpp]
2026-06-23 Firmware: silence ROM ets_printf path to kill last '���' line
    The WiFi PHY / driver code in ROM calls ets_printf() for low-level radio
    diagnostics. That path goes through the ROM putchar installed via
    ets_install_putc1() — it bypasses esp_log_write(), the vprintf hook,
    and therefore our mutex. Result: a single garbled line at the start of
    every fresh WiFi association, replacing the head of the '[wifi]
    connected to ...' line with high-bit bytes the terminal renders as '�'.
    Install a no-op putchar via ets_install_putc1() and clear the channel-2
    hook. ROM ets_printf now silently drops every byte. The regular panic
    handler uses its own UART path, so crash dumps still print.
    [log_serial.cpp]
2026-06-23 Android: adaptive launcher icon (sun + rooftop solar panel)
    App previously shipped with no icon at all, so the system rendered the
    default green bug-droid placeholder. Added an adaptive icon defined
    purely as vector drawables — no PNG asset variants needed since
    minSdk = 26 already supports adaptive icons natively.
    drawable/ic_launcher_foreground.xml — bright yellow sun with 8 rays
    above a tilted trapezoidal solar panel array in dark blue. Sized
    to fit inside the 72dp adaptive-icon safe zone so it survives the
    circle / squircle / teardrop masks every launcher applies.
    values/ic_launcher_background.xml — sky-blue (#7FB8E6) background.
    mipmap-anydpi-v26/ic_launcher.x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
2026-06-24 Android: clearer scan states + scrollable range chips
    Three UX fixes from on-device testing:
    1. "Bluetooth is off" no longer shown alongside "Scanning…". When BT is
    off, startScan() now resets scanning=false and shows a clear
    actionable banner ("Bluetooth is turned off. Turn it on, then tap
    Scan."). The empty-state placeholder is suppressed whenever an error
    banner is present, so the two messages can't contradict each other.
    2. "StandaloneCoroutine was cancelled" no longer leaks to the user. The
    scan collector caught CancellationException in its generic Throwable
    branch and rendered the raw message. It now rethrows cancellation so
    structured concurrency unwinds clean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
2026-06-24 Backend + Android: BLE-relay sync via session auth (no device token)
    ingest.php previously required X-Device-Token, which only the firmware
    has — the Android app, which doesn't, was getting 401 'unauthorized'
    whenever a user tapped 'Sync now' on the Device Detail screen.
    Backend: ingest.php now accepts either (a) the legacy X-Device-Token
    header (firmware path, unchanged), or (b) a cookie session + X-CSRF
    header (Android relay path). Session-authed ingest is gated to devices
    the user already owns or unowned devices being provisioned, so a
    logged-in user can't spam data into someone else's row.
    Android: CloudClient.ingest() now sends X-CSRF on every call and only
    includes X-Device-Token w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
2026-06-24 Android: PersistentCookieStorage — handle Cookie.maxAge nullable in Ktor 3.x
2026-06-24 Android: fix stale sync count + add Wi-Fi scan polling and save feedback
    Sync: refreshInfo() launched its own coroutine, so syncNow() fired the
    device-info read immediately after writeSyncAck() — before the firmware
    had truncated /log.csv and recomputed unsynced_count. The button kept
    showing the old "Sync N row(s)" until a manual refresh. Extracted a
    suspending readInfoNow(); syncNow() now waits ~1.2 s for the firmware to
    process the ACK, then awaits the read so the count updates in place.
    Wi-Fi scan: the screen relied solely on the WIFI_SCAN NOTIFY, which is
    racy (firmware can push before Kable enables the CCCD, or push once and
    we miss it) — so the SSID list often stayed empty. Now w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
2026-06-24 Android: show Wi-Fi connected status in Device Info card
    The Device Info card had no indication of whether the ESP32 is on Wi-Fi
    — the user had to open Configure Wi-Fi to find out. Added a "Wi-Fi" row
    that reads the device's Wi-Fi Status characteristic:
    - Green "Connected · <SSID> · <ip>" when the station link is up.
    - Red "<status> · <detail>" (e.g. "Failed", "Disconnected") otherwise.
    - "—" until the first status read completes.
    DeviceDetailViewModel reads Wi-Fi status alongside device info (so it
    refreshes with the rest of the card and after a sync) and also
    subscribes to the Wi-Fi Status NOTIFY on connect, so the line updates
    live as the device associates or drops without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
2026-06-24 Firmware+Android: real Wi-Fi status (SSID/IP) + reorder action buttons
    Wi-Fi status: the BLE Wi-Fi Status characteristic mirrored the transient
    connectivity state-machine enum, which returns to IDLE between sync
    cycles even while the STA stays joined — so the app's Device Info card
    showed "Idle" for an online device and never the SSID. ble_service tick()
    now builds the status JSON from the actual station association:
    WiFi.isConnected() -> {"status":"connected","ssid":..,"ip":..}, else the
    transient scanning/connecting state or "disconnected". Notify fires when
    the serialized string changes (so SSID/IP updates propagate). The app's
    existing WifiField already renders connected (green, SSID·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
2026-06-24 Firmware: keep Wi-Fi associated between sync cycles
    run_cycle() called WiFi.disconnect() at the end of every cycle and
    begin() set setAutoReconnect(false), so the STA was joined only during
    the brief connect+POST window (~5-10 s) and dropped for the rest of the
    2-minute interval. That's why the serial showed "connected" but the app
    (which now reports the real WiFi.isConnected() state) correctly showed
    "Disconnected" ~95% of the time, and why every cycle re-logged
    "[wifi] connected to ..." with the associated IDF re-association noise.
    For a mains-powered monitor there's no reason to drop the link. Now:
    - begin() sets setAutoReconnect(true) + persistent(false), so the STA
    auto-rejoins i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
    [wifi_sync.cpp]
2026-06-24 Firmware: add Wi-Fi status LED on GPIO 2
    New led module drives the on-board LED as a Wi-Fi indicator:
    - Wi-Fi disconnected -> slow continuous blink (~3 Hz, searching)
    - Wi-Fi connected & idle -> off
    - Data being POSTed -> fast flicker for ~800 ms per upload
    led::tick() is called every ~50 ms from loop() (which already runs at
    that cadence feeding the serial console), reads WiFi.isConnected() and a
    TX-pulse deadline, and toggles the pin accordingly. wifi_sync calls
    led::signal_tx() right before each ingest POST to trigger the flicker.
    Pin/behaviour are configurable in config.h: PIN_STATUS_LED (default
    GPIO 2, freed when OLED_RST moved to GPIO 19), LED_ACTIVE_HIGH, and the
    t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
2026-06-25 Report: hourly line chart, one line per day, weekly/monthly modes
    Replaced the weekly/monthly bar totals with an overlaid hourly line
    chart per request:
    - X axis = hour of day (00:00..23:00, IST)
    - Y axis = kWh generated that hour
    - one line per day; legend shows the day (e.g. "25-Jun")
    Two modes:
    - Weekly: last 7 days including today (7 lines).
    - Monthly: <input type=month> picker (capped at the current month);
    one line per day of the selected month.
    Data comes from readings.php aggregate=hourly; points are bucketed in JS
    by date -> 24-hour array. Ranges are built from PHP-provided IST anchors
    (today / current month) and plain YYYY-MM(-DD) strings the server reads
    as IST, so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
2026-06-25 Report: extend hour axis to 24:00 so the final hour isn't clipped
    The hourly bucket at 23:00 covers 23:00->24:00, but the axis stopped at
    23:00 and the To dropdown capped at 23:00, so that last hour's line
    segment was never drawn ("only till 23:00, next hour missing").
    - Hour labels now run 00:00..24:00 (25 boundary ticks).
    - To dropdown ranges 01:00..24:00 (inclusive end); From stays 00:00..23:00.
    - Each day's 24 values get a trailing 24:00 boundary point so the final
    segment renders; slicing is [from..to] inclusive of the end boundary.
    - To<=From is clamped to From+1 so at least one hour always shows.
    Default window unchanged (06:00..18:00); pick To=19:00 to see through
    19:00, or To=24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
2026-06-25 Android: +Add on scan screen now confirms and returns to the list
    The +Add button only enqueued a DataStore write and did nothing visible
    — the user stayed on the scan screen with no signal that anything had
    happened, so it felt stuck.
    Now the scan composable's onAdd handler pops back to the saved-devices
    list after queuing the write, and MainViewModel.addDevice() fires a
    short Toast ("Added <name>") so the user gets explicit feedback that
    the device was saved.
2026-07-04 Feature: log hourly RTC drift to the server
    The DS3231 is compared against NTP on every Wi-Fi cycle; this captures
    that comparison as a health metric so a failing crystal / dying backup
    battery shows up as growing drift instead of silently corrupting
    timestamps.
    Firmware:
    - ntp_sync_if_due() samples signed drift (RTC epoch - NTP epoch) at most
    once per RTC_DRIFT_LOG_INTERVAL_SEC (3600), just before any writeback,
    and stashes it with the sample's wall-clock time.
    - post_batch() attaches rtc_drift_sec + rtc_drift_at (ISO) to the next
    ingest payload; the pending sample is cleared only after a 200.
    - New rtc_drift_log table (device_id, measured_at, drift_sec, created_at)
    in sc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
    [config.h, wifi_sync.cpp]
2026-07-04 Add headless DS1307 firmware variant (no OLED)
    New firmware/solar_monitor_ds1307/ variant, a sibling to the existing
    SSD1306 + DS3231 build. Kept separate; not merged with it.
    Changes vs the SSD1306_ds3231 variant:
    - RTC: RTC_DS3231 -> RTC_DS1307. lostPower()/OSF replaced with the DS1307
    clock-halt (CH) bit via isrunning(); adjust() clears CH on write.
    - I2C clock lowered to 100 kHz (DS1307 is standard-mode only).
    - OLED removed: dropped display.cpp/.h and all display:: calls; boot/
    storage-fail messages now go to serial only.
    - config.h: removed SSD1306 SPI pin map; DISPLAY_REFRESH_MS renamed to
    SAMPLE_INTERVAL_MS (PZEM sample cadence).
    - Updated DS3231/OLED references in comments an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
    [ble_service.cpp, ble_service.h, config.h, health.cpp, health.h, identity.cpp, identity.h, led.cpp]
2026-07-04 BLE: gate access with HMAC-SHA256 pre-shared-key challenge-response
    BLE could no longer be left open — anyone in range could read the buffered
    energy log or push Wi-Fi credentials. Add app-layer authentication over a
    pre-shared key that is never transmitted:
    - Firmware generates a fresh random nonce per connection on a new Auth
    Challenge characteristic. The app writes HMAC_SHA256(key=PSK, msg=nonce)
    to a new Auth Response characteristic; the firmware recomputes and
    constant-time compares. Until authenticated, every sensitive read returns
    {"error":"unauthorized"} and every write is dropped. The nonce rotates on
    connect and on each failed attempt to stop replay.
    - Android computes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
    [ble_service.cpp, config.h]
2026-07-07 firmware(SSD1306_ds3231): remap OLED/I2C GPIO pins
    Rearrange the ESP32 pin map for the SSD1306/DS3231 variant:
    - OLED (software SPI): SCK 23, MOSI 22, RST 21, DC 19, CS 18. Moving CS
    off GPIO 5 frees a strapping pin.
    - I2C: SDA 4, SCL 15. GPIO 15 is a strapping pin but idles HIGH via the
    DS3231 module pull-ups, so boot is unaffected. Deliberately avoids
    GPIO 2 (the on-board status LED, driven by led.cpp) and GPIO 0
    (boot/auto-program strapping pin).
    All ten configured pins are unique; no peripheral hardcodes GPIO numbers,
    so this is a config.h-only change. display.cpp comment updated to reflect
    the new MOSI pin (SW SPI is still required). ds1307 variant untouched.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
    [config.h, display.cpp]
2026-07-07 backend: whole-range meter delta for totals + telescoping buckets
    Summing chart bars dropped the energy between buckets (overnight/between-hour
    gaps) and read low. Make totals use the meter's single MAX-MIN over the window
    and make daily/monthly buckets telescope so they sum exactly to it.
    api/readings.php
    - Add total_kwh: one MAX(energy_wh)-MIN(energy_wh) over the requested window,
    in kWh. Returned for every aggregate.
    - Telescoping daily/monthly buckets: each bucket now spans from its own first
    reading to the next bucket's first reading (last bucket absorbs the tail up
    to the window max). Buckets sum exactly to total_kwh; nothing lost in gaps.
    Hourly stays a plain within-bucket de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
2026-07-07 admin card layout + old-meter baseline (capacity_kw)
    Admin devices: 2-line card layout (no horizontal scroll)
    - Replace the wide multi-column devices table with a card list. Each device
    renders on two wrapping lines: identity/assignment (id, name, location,
    Old kWh, owner), then interval/status/actions. Location gets the most flex
    room so it isn't truncated. Nothing overflows the viewport.
    - JS handlers retargeted from tr/td to .dev; field classes unchanged.
    Use device's old-meter reading (capacity_kw) in dashboard totals
    - capacity_kw was stored/returned but never surfaced. Repurpose it as the
    replaced meter's last reading (kWh) at install and add it to the dashboard
    Today and Pe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
2026-07-07 dashboard: add signed adjustment_kwh to match the physical meter
    Add a per-device manual correction so the dashboard's cumulative Period total
    lines up with the actual solar generation meter. Displayed Period total is now
    Old kWh (baseline) + generated + adjustment.
    - schema: new energy_devices.adjustment_kwh DECIMAL(12,2) NOT NULL DEFAULT 0
    (signed; migrations/004). Set it to (actual meter - shown total).
    - api/readings.php: return adjustment_kwh.
    - api/admin_devices.php: rename action stores adjustment_kwh; list returns it.
    - admin/devices.php: new "Adjust kWh" card field with tooltip; saved with the
    other device fields.
    - dashboard/index.php: add adjustment to stat-total only (not To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
2026-07-07 Log Wi-Fi RSSI alongside the hourly RTC drift sample
    The firmware already reports an hourly RTC-vs-NTP drift sample on the ingest
    POST; piggyback the Wi-Fi signal strength on the same sample so weak-signal
    sites are visible from the server.
    - firmware (both variants): capture WiFi.RSSI() when the drift sample is taken
    (still connected right after NTP) and send it as rssi_dbm on the POST.
    - api/ingest.php: read rssi_dbm (validate as negative dBm; sentinel 0/out-of-
    range -> NULL) and store it with the drift row.
    - schema: rtc_drift_log.rssi_dbm INT NULL (schema.sql + migrations/005).
    - admin/devices.php: show the latest RSSI ("-67 dBm") next to RTC drift.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
    [wifi_sync.cpp]
2026-07-08 android: sync cloud dashboard totals with backend changes
    Mirror the web dashboard's total logic in the companion app now that the
    backend returns total_kwh and treats capacity_kw as the old-meter baseline
    plus a signed adjustment_kwh.
    - CloudModels: ReadingsResponse gains total_kwh and adjustment_kwh
    (capacity_kw already present). Additive with defaults; client already uses
    ignoreUnknownKeys.
    - CloudViewModel: carry total_kwh / capacity_kw / adjustment_kwh into CloudUi.
    - CloudDashboardScreen: Period kWh = total_kwh + old-meter baseline +
    adjustment (whole-window meter delta), not the sum of the chart bars; falls
    back to summing bars if an older backend omits total_kwh.
    - DeviceDet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
2026-07-08 Add battery voltage sense on GPIO35 to the hourly health report
    Sense the supply/battery voltage on GPIO35 (ADC1, input-only) and report
    it alongside the existing RTC drift and Wi-Fi RSSI in the ingest POST.
    ADC1 is used deliberately: ADC2 is shared with the Wi-Fi radio, so ADC1
    stays readable while the radio is active. GPIO35 is input-only, so it
    can't drive anything and leaves the GPIO-capable pins free. The same pin
    is used on both firmware variants so board wiring is identical no matter
    which build is flashed.
    - New battery module (begin/read_volts): averages BATTERY_SAMPLES ADC
    reads via analogReadMilliVolts() (eFuse calibration applied by the
    Arduino core) and scales by BATTERY_D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
    [config.h, shared_state.h, solar_monitor_SSD1306_ds3231.ino, solar_monitor_ds1307.ino, wifi_sync.cpp]
2026-07-08 Reframe GPIO35 sense as RTC coin-cell (CR2032), not the solar battery
    The sensed voltage is the DS3231/DS1307 backup coin cell (CR2032, ~3 V),
    not the solar/main battery. A CR2032 never exceeds ~3.3 V, so it wires
    straight to the ADC pin with no divider — removing the resistor-divider
    handling that only made sense for a higher-voltage source.
    - Rename battery module -> coin_cell (begin/read_volts), namespace and
    files, in both firmware variants.
    - config.h: PIN_COIN_CELL_SENSE / COIN_CELL_SAMPLES; drop the divider
    ratio (direct connection to the coin cell + / VBAT node).
    - SharedState.battery_v -> coin_cell_v; POST field battery_v ->
    coin_cell_v, reported next to rtc_drift_sec and r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
2026-07-09 Revert "Android: log out of cloud when the user closes the app"
    Per follow-up, closing the app (swiping it away from recents) should also
    keep the user signed in — the session should persist across backgrounding
    and close alike, and only the in-app "Sign out" button ends it.
    That leaves no trigger for auto-logout on exit, so this restores the
    original persist-across-restarts behavior: removes SessionGuardService,
    its manifest entry and MainActivity start, CloudClient.logoutOnExit(), and
    the awaited-flush change to PersistentCookieStorage.clear().
    This reverts commit e51f0d6.
    Claude-Session: https://claude.ai/code/session_015XMzMDAL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
2026-07-09 Backend: persist RTC coin-cell voltage from the ingest payload
    The firmware reports coin_cell_v (RTC CR2032 backup voltage) alongside the
    hourly rtc_drift_sec / rssi_dbm sample, but the backend was dropping it.
    - migrations/006_rtc_drift_log_coin_cell.sql: ADD COLUMN coin_cell_v
    DECIMAL(5,3) NULL to rtc_drift_log (run once; ADD COLUMN not idempotent).
    - schema.sql: same column in the canonical CREATE TABLE, kept in sync with
    the migrations.
    - ingest.php: parse coin_cell_v, drop out-of-range values (incl. the
    firmware sentinel 0.0 = "not captured"), and store it in the drift row.
    - admin/devices.php: show the latest coin-cell voltage per device next to
    RTC drift and Wi-Fi.
    Co-Author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
2026-07-11 Replace DEVICE_TOKEN with placeholder value
2026-08-23 Android: upload pending device logs over BLE on app start
    The ESP32 buffers log rows and normally drains them over Wi-Fi. Where a
    device has no usable AP that buffer only moved when the user opened the
    device and tapped "Sync now". Now the app does it automatically at launch.
    On start, if Bluetooth is on and BLUETOOTH_CONNECT is granted, the app
    walks every saved device strictly one at a time — connect, authenticate,
    pull rows, POST, ACK so the firmware truncates /log.csv, disconnect —
    before starting the next. Phones don't handle parallel GATT connections,
    and an unreachable device only costs its connect timeout before the pass
    moves on. Progress and per-device results show on the My d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
2026-08-23 Android: trigger the all-devices upload from Sync now, not app start
    Syncing automatically at launch was the wrong trigger — the button-driven
    flow is the one that works. The all-devices relay pass now runs only when
    the user taps it.
    - My devices gains a Sync now button that uploads pending rows from every
    saved device. It is disabled while a pass runs so repeat taps can't
    stack overlapping sweeps.
    - Bluetooth is checked before any device is touched: if it's off (or
    BLUETOOTH_CONNECT is missing) the pass is skipped and the screen says
    so, rather than failing device by device.
    - Nothing runs on its own: MainActivity no longer kicks off a pass in
    onCreate, and the once-per-proces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
2026-08-25 Add SSD1306 + DS1307 firmware variant
    Third sketch folder combining the SSD1306 OLED with the cheaper DS1307
    RTC, alongside the existing OLED+DS3231 and headless+DS1307 builds.
    Built from the OLED+DS3231 variant, taking rtc.{h,cpp}, ble_service.cpp
    and wifi_sync.cpp verbatim from the headless DS1307 build — so the RTC
    modules are byte-identical to that variant and display.* is byte-identical
    to the OLED one. The only RTC code difference is DS3231 lostPower() (OSF
    bit) vs DS1307 !isrunning() (clock-halt bit); RTClib and U8g2 are both
    already vendored in libraries.zip, so no new dependencies.
    Pin map: I2C stays on GPIO 4/15 rather than the 22/23 the headless build
    uses, because those two p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
2026-08-25 Share one libraries.zip across all firmware variants
    The vendored library snapshot was duplicated in each sketch folder — three
    byte-identical 16 MB copies (same md5), ~48 MB of the repo. Arduino ignores
    non-source files in a sketch folder, so nothing needed it to be per-variant.
    Move it to firmware/libraries.zip and drop the copies, reclaiming ~32 MB.
    README and PROVISIONING now point at the shared path, and PROVISIONING
    explains it as the alternative to installing via Library Manager.
    Claude-Session: https://claude.ai/code/session_015XMzMDALcn6dpTey9zEN1V
2026-08-27 Move RTC I2C SCL to GPIO 13 on all firmware variants
    GPIO 15 is a strapping pin; GPIO 13 was already documented as free
    and non-strapping, so move SCL there on both OLED builds and unify
    the headless DS1307 build onto the same SCL pin for consistency.
    Update PINOUT.md to match.
2026-08-27 Keep headless DS1307 firmware's SCL on GPIO 23
    Only the OLED builds needed to move off strapping-pin GPIO 15; the
    headless variant's I2C already lived on GPIO 22/23 with no conflict,
    so leave PIN_I2C_SCL there unchanged.
2026-08-27 Align ds1307 pin map layout with the SSD1306_ds3231 reference
    Move RTC_WRITEBACK_DRIFT_SEC / RTC_DRIFT_LOG_INTERVAL_SEC after the
    coin-cell sense block to match the section order in
    solar_monitor_SSD1306_ds3231/config.h. I2C pins (SDA 22 / SCL 23)
    are unchanged.
2026-08-27 Unify RTC I2C pins to SDA 4 / SCL 13 across all firmware variants
    The headless DS1307 build now wires I2C the same as the OLED builds
    (GPIO 4 SDA / 13 SCL) instead of GPIO 22/23, so RTC wiring is
    identical no matter which firmware is flashed. Correct the stale
    strapping-pin comment on the DS3231 SCL line (GPIO 13 isn't a
    strapping pin) and update PINOUT.md's tables, wiring diagram, and
    free-pin notes to match.
    [config.h]
2026-08-27 Add PCB design file (DipTrace)
    Adds hardware/solar_monitor.dip, the DipTrace project for the
    solar monitor board.
    [solar_monitor.dip]
2026-08-27 Migrate backend from aromen.biz/solar to the solar.aromen.biz subdomain
    The backend now lives at the root of its own subdomain instead of a
    /solar path prefix under the main domain:
    - Move backend/public_html/solar/* up to backend/public_html/*, since
    the subdomain's document root replaces the old /solar folder.
    - Strip the /solar/ prefix from all internal URLs, redirects, fetch()
    calls, and asset links across the PHP pages.
    - Adjust _db.php's secrets.php lookup paths (dirname() depth and the
    in-tree fallback) for the new one-level-shallower directory nesting.
    - Update INGEST_HOST_DEFAULT to https://solar.aromen.biz and
    INGEST_PATH to /api/ingest.php in all three firmware variants,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
    [ble_service.cpp, config.h, storage.h]
2026-08-27 Android: surface devices.php auth failures instead of hiding them
    refreshDevices() decoded the DevicesResponse and set ui.devices from
    it unconditionally, never checking resp.ok. A 401 login_required
    response is still valid, parseable JSON with an empty devices array,
    so an expired/invalid session silently rendered as "you have zero
    devices" on an otherwise-normal-looking logged-in screen, with no
    error and no way to tell it apart from actually having no devices.
    Now a non-ok response resets the UI to the login screen with the
    server's error message, matching what tryAutoFetch() already does
    on cold start.
2026-08-27 Android: log cookie store activity to diagnose session drop after login
    Login succeeds (server confirms the password and returns a session
    cookie), but the very next devices() call comes back unauthenticated,
    and the same backend works fine from a browser — so the cookie set by
    the login response isn't making it onto the following request inside
    the app specifically. Add Logcat tracing (tag "CloudCookies") at the
    two chokepoints — addCookie() on responses, get() on requests — to see
    exactly what's being stored and what's being sent, without guessing
    further from static code reading alone.
    Also preserve the typed username when a stale/invalid session bounces
    the user back to the login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
2026-08-27 Show the saved Wi-Fi SSID in the app, and fix the password label wrap
    All 3 firmware variants: the Wi-Fi Status BLE characteristic now
    includes saved_ssid (from the single stored credential) alongside the
    live connection status, so the app can show what's configured even
    while the device is disconnected or still scanning — previously the
    "ssid" field was only populated while actively associated.
    Android: surface saved_ssid on the Configure Wi-Fi screen (only when
    it differs from the live connection SSID, to avoid a redundant line),
    and shrink the password field's label so "leave blank for open
    network" fits on one line instead of wrapping to two.
    [ble_service.cpp]
2026-08-27 Add PZEM energy reset and NVS erase commands (all 3 firmware + app)
    All 3 firmware variants: new BLE characteristics, Device Command
    (WRITE) and Command Result (READ/NOTIFY), accepting:
    {"cmd":"reset_pzem"} - zeros the PZEM's cumulative
    energy counter via the existing (previously unused)
    pzem::reset_energy(). Today/session totals already self-heal on
    the next sample when the counter rolls backward, so no other
    state needs touching.
    {"cmd":"erase_nvs","confirm":true} - wipes both NVS namespaces
    (Wi-Fi credentials, ingest host/log-interval overrides, boot
    history, sync state, today's energy anchor) via a new
    storage::erase_all_nvs(), replies, the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
    [ble_service.cpp, config.h, storage.cpp]
2026-08-27 Fix GATT_ERROR(133) on reset_pzem/erase_nvs: defer work off the BLE callback
    Root cause: DeviceCommandCallbacks::onWrite() ran the PZEM Modbus reset
    and the NVS flash erase (Preferences::clear()) synchronously inside the
    NimBLE write callback, then erase_nvs additionally called delay(300) +
    ESP.restart() there too. Blocking flash/serial I/O inside a GATT write
    callback can stall the BLE host task long enough that it never finishes
    the ATT write response for that same write — the client sees a
    transport-level GATT_ERROR regardless of whether the requested operation
    itself would have succeeded. Confirmed against a working sibling project
    (uploaded for comparison) that uses exactly this reque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
    [ble_service.cpp, pzem.cpp, pzem.h, solar_monitor_SSD1306_ds1307.ino, solar_monitor_SSD1306_ds3231.ino, solar_monitor_ds1307.ino]
2026-08-27 Give the serial port more time to start before the boot banner
    50ms wasn't always enough for the USB-CDC/UART serial console to be
    ready, dropping the "=== Solar Monitor boot ===" banner and early log
    lines on some hosts. Bump to 1000ms in all 3 firmware variants.
2026-08-29 Allow self-service device reassignment via Register
    claim_device.php previously refused (409 owned_by_other_user) when a
    logged-in user tried to register a device already claimed by someone
    else, requiring an admin to re-bind it manually. Now claiming always
    sets owner_user_id to whichever user is currently logged in and taps
    Register, regardless of any prior owner.
    Removed the now-unreachable ClaimStage.Conflict path and its "ask an
    admin" message from the Android app, since the server can no longer
    return that error.
    Note: this intentionally trades away the anti-hijack protection —
    anyone who knows a device_id (visible over BLE) can now claim it away
    from its current owner from their o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
2026-08-29 Show cloud friendly_name on My devices when logged in
    SavedDevicesScreen only ever showed each device's locally-remembered
    name (e.g. "Solar (FC:66)", derived from the BLE advertising name at
    add-time), even after the device was registered and renamed on the
    Cloud tab.
    MainViewModel now fetches /api/devices.php (best-effort, refreshed
    each time the screen is opened) and overlays each saved device's
    cloud friendly_name — matched by the firmware device_id, not the BLE
    MAC — onto the displayed list via a new displayDevices flow. Falls
    back to the local name for unregistered devices or when logged out;
    a logout also clears the cached names on the next visit.
2026-08-29 Fix: persist device_id after connect so cloud friendly names can match
    Device.id was documented as "filled in after the first connect" but
    nothing in the app ever actually did that — it stayed null forever
    for every saved device (BleScanner always constructs Device with the
    default null id, and no code path updated it afterward). The new
    cloud friendly_name overlay on My devices matches by device_id, so it
    could never find anything to overlay, regardless of registration
    state.
    DeviceDetailViewModel now saves the authoritative device_id (from a
    successful Device Info read) back onto the device's DeviceStore entry.
    This also matters more than it used to now that this MAC-based
    fallback name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
2026-08-29 Preserve seq_hwm across NVS erase to avoid silent reading loss
    solar_readings has UNIQUE(device_id, seq), and ingest.php inserts with
    "ON DUPLICATE KEY UPDATE id = id". Wiping seq_hwm restarted the
    device's sequence counter at 0, so every reading logged after an erase
    reused a seq the server already had for that device_id: the insert
    no-opped, but the server still reported that seq as acked, and the
    firmware then truncated those rows from its local buffer. Result was
    permanent loss of every reading until the counter climbed back past
    the pre-erase high-water mark — silent, with no error on either side.
    Keep seq_hwm through the wipe so post-erase seqs always continue past
    whatever the serv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
    [storage.cpp, storage.h]
2026-08-29 Revert "Preserve seq_hwm across NVS erase to avoid silent reading loss"
    This reverts commit 49f0c4b7387c359cd156667e1f8051ec0cf9f229.
    [storage.cpp, storage.h]
2026-08-29 Clear a device's cloud readings when the app erases its NVS
    Erasing NVS restarts the firmware's seq counter at 1, but the server
    keys readings on (device_id, seq) and ingest.php inserts with
    "ON DUPLICATE KEY UPDATE id = id". Stale rows therefore shadowed every
    post-erase reading: the insert no-opped, the server still reported the
    seq as acked, and the firmware dropped its local copy — silent data
    loss until the counter climbed past the old high-water mark.
    New POST /api/reset_device_data.php deletes a device's solar_readings
    and rtc_drift_log rows and zeroes its device_meta counters, keeping the
    device registered (owner, friendly name, location, interval override
    all survive). Session +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
2026-08-29 Let users name a device locally, without a cloud login
    Device names came only from the BLE scan (often a MAC-derived fallback
    like "Solar (FC:66)"), and the sole way to set a real one was the
    Register-with-cloud dialog, which needs an account. Adding a device
    while signed out left no way to label it.
    My devices now has a rename action per card, storing the name on the
    phone via a new DeviceStore.rename(). New Device.nameIsCustom records
    that the user chose it, which also settles precedence against the
    cloud overlay added earlier: a typed name wins and is not undone by
    signing in, while an untouched scan-derived name still yields to the
    cloud's friendly_name. Clearing the field drops the fla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
2026-08-29 Revert "Let users name a device locally, without a cloud login"
    This reverts commit 4eb00dd100ec3e022071b7e66cf52851e7e4a190.
2026-08-29 Fetch registered device names without a cloud login
    Friendly names only appeared once the user signed in, since the device
    list endpoint requires a session — a device added while signed out kept
    its scan-derived name ("Solar (FC:66)").
    New public GET /api/device_names.php maps device_ids to friendly_name
    and nothing else: no readings, owner, or location, and only for a
    caller that already knows the exact device_id, which is derived from
    the MAC and visible to anyone in BLE range. Batch capped at 25 ids so
    it can't be used to enumerate names.
    refreshCloudNames() still prefers the authenticated list when signed in
    (it covers devices not saved on this phone) and falls back to the
    public loo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
2026-08-29 Plot the Power chart at the device's real logging resolution
    Both dashboard charts shared one readings.php query, so on Today and
    Last 24 hours the power line was drawn from hourly P_avg — a single
    flat average per hour that flattens out every load switch, even though
    the device logs every 5 minutes.
    Power now fetches its own raw series for those two ranges while the
    energy bars stay hourly, giving ~288 points a day instead of 24 (well
    under the endpoint's 5000-row cap; 7d and longer keep their aggregates,
    where raw would blow past it). Point markers are dropped and the line
    thinned once a series passes 60 points so the denser trace stays
    readable, and the label switches to "Power (W)" si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
2026-08-29 Require a cloud session before erasing a device
    "Erase device data" wipes the device's NVS, which restarts the firmware's
    seq counter at 1. solar_readings keys on (device_id, seq), so any cloud row
    that outlives the wipe shadows a new reading: ingest.php drops it via
    ON DUPLICATE KEY UPDATE but still returns it in acked_up_to_seq, and the
    firmware then deletes its only copy. The two wipes have to happen together.
    Until now the cloud half was best-effort and ran *after* the BLE command,
    so erasing while signed out wiped the device and left its rows in place --
    exactly the state that loses data.
    Gate the action on a live session that owns the device:
    - EraseGate models whether the cloud row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
2026-08-29 Point the blocked-erase message at claiming the device
    ingest.php auto-registers a device with owner_user_id NULL, and devices.php
    hides unclaimed devices from non-admins, so the common blocked case is a
    registered-but-unclaimed device -- not one owned by somebody else. The old
    copy told the user to "ask its owner", when the remedy is the Register with
    cloud action already on that screen.
    The app cannot tell unclaimed from foreign-owned: devices.php omits both for
    a non-admin and device_names.php returns only names. reset_device_data.php
    refuses both alike, so they stay one state, renamed NotYours -> NotLinked,
    with copy that names the fix that works either way.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
2026-08-30 Give the DS3231 OLED build the working ingest token; fix stale pin comment
    The SSD1306+DS3231 build still carried the "token" placeholder, so its ingest
    POSTs were rejected while the DS1307 build authenticated fine. DEVICE_TOKEN is
    a single shared secret (ingest.php compares it with hash_equals), so the two
    builds use the same value.
    Also corrects the DS1307 sketch header, which claimed I2C sits on GPIO 4/15 to
    clear the OLED's SPI pins. Both halves were wrong: config.h has used SDA 4 /
    SCL 13 since the pins were unified across variants, and the OLED is bit-banged
    software SPI on GPIO 18-23, which never overlapped the I2C pins.
    Claude-S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
    [config.h, solar_monitor_SSD1306_ds1307.ino]
2026-08-30 Point NTP at India-local servers in all three firmware variants
    pool.ntp.org resolves to whichever zone the resolver picks and time.nist.gov
    is US-hosted, so both could land far from the device. TZ_INFO is IST-5:30, so
    prefer sources close to it: time.google.com is anycast with Indian PoPs, and
    in.pool.ntp.org is the country pool.
    Both are passed to configTzTime() unchanged in wifi_sync.cpp -- no code
    change, only the endpoints.
    Claude-Session: https://claude.ai/code/session_01MnBUHyD89tARS8QdySpWqq
    [config.h]
2026-08-30 Make today/total the OLED's headline figure; show DD-MM | HH:MM
    The two energy readings each had a 6x10 row and read no better than the
    voltage line beside them. Merge them into one large-font "0.05/0.22 kWh"
    across the band both rows used to occupy, so the number that matters is
    legible from across the room, and move the label to the status row -- it
    says the same thing every frame, the numbers do not.
    The label still carries what the old rows did: Today, Today* when the
    midnight anchor was missed and the day total understates, or Session when
    there is no wall clock to define a day.
    The clock stamp gains the month (DD-MM | HH:MM, tm_mon is 0-based) and drops
    to 5x7 so the wider stamp stil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
    [display.cpp]
2026-08-30 Stop the OLED fault banner running off the left edge
    "PZEM ERROR" at ncenB14 is wider than the 128 px panel, and centring it
    computed a negative x -- u8g2 drew from there, so the leading glyph fell off
    the display and it read "ZEM ERROR" on hardware. "BUFFER FULL" is wider still.
    Both the fault banner and the energy row now go through one draw_fitted()
    helper that walks a font ladder until the string fits, and clamps to x=0 if
    even the smallest overflows, so a too-long string loses its tail rather than
    its first letter.
    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
    [display.cpp]
2026-09-10 Document the three firmware builds vs the C3 AC-energy-meter upload
    Compares firmware/solar_monitor_ds1307, solar_monitor_SSD1306_ds1307 and
    solar_monitor_SSD1306_ds3231 against the uploaded
    esp32.supermini_ds1307_ac_energy_meter tree, with the relay subsystem
    deliberately out of scope.
    Covers the C3 retarget (pin map, single-core task pinning, USB-CDC), the
    radio-coexistence work (TX-power capping, BLE/Wi-Fi handoff,
    auto-reconnect off, scan-gating removal), the stack/heap/watchdog
    hardening, PZEM retries, the coin-cell and ingest-payload changes, the
    BLE auth and characteristic rework, and the factory-reset rewrite.
    Also records two findings in the current tree: solar_monitor_ds1307 stil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
2026-09-10 Rest the radio periodically so a stale association can't persist
    try_connect_known() reuses any association reporting WL_CONNECTED, and
    run_cycle() only tears the link down when that function fails. So once
    the STA holds a stale association -- routine with a phone hotspot after
    a band switch, DHCP renewal or a carrier blip -- every POST fails at
    DNS/TCP while the driver still reports connected, and nothing forces a
    reassociation. The only escape was the STUCK_WIFI_REBOOT_SEC reboot six
    hours later.
    Take the radio fully off-air on a schedule instead: disassociate the STA,
    power the Wi-Fi PHY down (WIFI_OFF), stop BLE advertising, hold for
    RADIO_REST_DURATION_SEC, then bring both back and req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
    [ble_service.cpp, ble_service.h, config.h, solar_monitor_SSD1306_ds1307.ino, solar_monitor_SSD1306_ds3231.ino, solar_monitor_ds1307.ino, wifi_sync.cpp, wifi_sync.h]
2026-09-10 Correct the ArduinoJson claims in the firmware comparison
    firmware/libraries.zip bundles ArduinoJson 7.4.3, where StaticJsonDocument<N>
    is a deprecated shim over JsonDocument and N only feeds capacity(). Two claims
    in the comparison assumed v6 semantics and are wrong:
    - The POST document was never 16 KB on the connectivity-task stack; it could
    not have been, since CONN_TASK_STACK is 12288 bytes. A file-scope static
    JsonDocument still heap-allocates its pools, so the upload's .bss move and
    its 12K->32K stack bump address a v6 problem that does not arise here.
    - The response document's 256 -> 1024 change is a no-op. A v7 JsonDocument
    grows to fit rather than failing the parse at a fix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
2026-09-10 Remove docs/FIRMWARE_COMPARISON.md
    The firmware comparison was a one-off analysis of an external build, not
    reference material the repo needs to carry.
    Claude-Session: https://claude.ai/code/session_01JYToy7zDvbJ8W5zeyzexcg
2026-09-10 Cut per-POST heap churn: smaller batches, body in .bss
    The bundled ArduinoJson is 7.4.3, where StaticJsonDocument<N> is a
    deprecated shim over JsonDocument and N only feeds capacity(). So
    post_batch()'s "16384" reserves nothing: the document is heap-allocated
    on demand in 1 KB pools, and the body String is assembled by the
    32-byte-chunked Arduino String writer through hundreds of concat()
    reallocations, each asking for a slightly larger contiguous block and
    abandoning the previous one.
    At SYNC_BATCH_SIZE 100 that was ~9 KB of pool plus an ~11 KB String
    churned through the heap every two minutes. Total free heap stays
    healthy under that pattern but the largest contiguous free block
    ratchets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
2026-09-10 Log heap per POST and reboot when fragmentation starves TLS
    Two additions to the same failure mode: the TLS handshake needs one
    large contiguous allocation (~16.5 KB with the IDF defaults), so it is
    the first thing to fail as the heap fragments -- while the STA stays
    associated and the app still shows "Connected".
    Visibility: every POST now logs free / largest-contiguous / min-since-
    boot. Fragmentation reads as `free` holding steady while `largest`
    ratchets down; a genuine leak drags both down together. That makes the
    next occurrence a one-line diagnosis instead of a multi-day mystery,
    and gives real numbers to tune the thresholds against.
    Recovery: post_batch() checks both figures before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
    [config.h, solar_monitor_SSD1306_ds1307.ino, solar_monitor_SSD1306_ds3231.ino, solar_monitor_ds1307.ino, wifi_sync.cpp, wifi_sync.h]
2026-09-10 Bound the TLS handshake so a stall can't panic-reboot the device
    http.setTimeout() bounds only the response read. It does not bound the
    TLS handshake, which WiFiClientSecure leaves at its 120 s default, nor
    the TCP connect. health::begin() installs a 30 s task watchdog with
    trigger_panic = true, and run_cycle() feeds it only once, at the top of
    the connectivity loop -- before a call that can block for ~140 s (15 s
    connect wait + 5 s NTP wait + up to 120 s handshake).
    So one stalled handshake on a marginal link -- a phone hotspot being the
    classic case -- panic-reboots the chip. That also explains a device that
    never recovers on its own: each panic returns uptime to zero, so the
    stuck-Wi-Fi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
    [config.h, wifi_sync.cpp]
2026-09-10 Stop the stuck-Wi-Fi watchdog rebooting healthy offline devices
    Field data from solar-475b78 (6 days, 575 rows) showed the old rule --
    "no successful POST for 6 h => the radio is wedged, reboot" -- firing on
    a perfectly healthy unit roughly twice a day. Six of ten reboots landed
    6h00m02s..6h00m11s after the last successful POST, to the second.
    The assumption was wrong for the deployment. That device is synced from
    a phone hotspot switched on morning and evening: measured median gap
    between syncs 6.6 h, maximum 33 h. Six hours offline is normal
    operation, not a fault, and the watchdog was punishing it for that. It
    also only ever punished boots that DID sync -- a boot that never posted
    return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
    [config.h, solar_monitor_SSD1306_ds1307.ino, solar_monitor_SSD1306_ds3231.ino, solar_monitor_ds1307.ino, wifi_sync.cpp, wifi_sync.h]
2026-09-10 Reboot nightly in the small hours for a clean slate
    A planned daily restart between 02:00 and 05:00 local, so each day starts
    on a fresh heap -- the one resource that never recovers on its own, since
    nothing compacts a C heap -- plus fresh Wi-Fi and BLE stacks and every
    counter and timer reset.
    Nothing is lost: buffered rows live in LittleFS and ship on the next
    sync, and boot_id, seq and the today-energy anchor are all in NVS. The
    cost is a few seconds of downtime and the first log row of the new boot
    arriving one log interval later.
    Three details that make it safe rather than a new failure mode:
    - The day it last fired is recorded in NVS, not RAM. In RAM the reboot
    would clear the fla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
    [config.h, solar_monitor_SSD1306_ds1307.ino, solar_monitor_SSD1306_ds3231.ino, solar_monitor_ds1307.ino, storage.cpp, storage.h]
2026-09-10 Retire two speculative behaviours; keep their diagnostics
    Both were written before the field data arrived and neither is
    justified by it.
    The blind 3 h radio rest was THE fix for a stale association until the
    stuck-Wi-Fi escalation gained an on-demand reassociation. That path does
    the same job strictly better -- it fires only when the device is
    demonstrably associated-but-not-posting, rather than taking the radio
    off-air eight times a day on the chance something is wrong. Timer off.
    The heap-floor reboot encodes a fragmentation theory with no supporting
    evidence from this fleet, using thresholds guessed from typical ESP32
    figures rather than measured on these boards. Acting on that risks a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
    [config.h, solar_monitor_SSD1306_ds1307.ino, solar_monitor_SSD1306_ds3231.ino, solar_monitor_ds1307.ino, wifi_sync.cpp]
2026-09-11 Always attempt the Wi-Fi connect; stop gating it on the scan
    try_connect_known() would not call WiFi.begin() at all unless the saved
    SSID turned up in a 200 ms/channel scan:
    if (found <= 0) return false;
    ...
    if (!match) continue;
    That strands the device against exactly the AP it is deployed with. A
    phone hotspot beacons weakly, powers down its radio when no client is
    attached, and may be hidden (the scan also passed show_hidden = false,
    so a hidden SSID could never match). A scan miss meant NO connection
    attempt -- for as long as the miss persisted -- and nothing in the log
    said why, because the failure path was a silent early return.
    Reported directly: on 09-09 the hotspot wa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
    [wifi_sync.cpp]
2026-09-11 Retune heap thresholds to measured values, not guesses
    First bench run of the new firmware reports, on a healthy board moments
    after boot:
    [wifi] heap free=23584 largest=18420 min=16620
    The thresholds shipped yesterday were HEAP_MIN_FREE_BYTES 30000 and
    HEAP_MIN_LARGEST_BLOCK_BYTES 20000 -- both ABOVE a healthy board's normal
    state. With HEAP_LOW_REBOOT_CYCLES non-zero that device would have
    deferred every POST and rebooted every ~10 minutes; with it at 0 it would
    simply log a low-heap warning on every POST forever. The comment claimed
    a healthy ESP32 shows a 60-110 KB largest block, which is wrong for this
    build by a factor of 3-5.
    The same log corrects the underlying assumption: fre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
    [config.h]
2026-09-11 Drop demo mode, make maintenance config server-pushed, hunt the heap leak
    Four changes, all three builds.
    1. PZEM_DEMO_MODE removed. The synthetic-reading path and its #if/#else
    scaffolding are gone from pzem.cpp; only the real Modbus path remains.
    2. Nightly reboot and radio rest become server-pushed, cached in NVS:
    nightly_reboot_enable / nightly_reboot_start_hour /
    nightly_reboot_end_hour / radio_rest_interval_sec /
    radio_rest_duration_sec. The macros are now *_DEFAULT and apply only
    until the server first pushes real values, matching how
    log_interval_sec already worked. Setters validate and reject rather
    than clamp, so a malformed push leaves the cached schedule in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
    [config.h, pzem.cpp, solar_monitor_SSD1306_ds1307.ino, solar_monitor_SSD1306_ds3231.ino, solar_monitor_ds1307.ino, storage.cpp, storage.h, wifi_sync.cpp]
2026-09-11 Trace the idle span too, or the leak hunt can miss entirely
    The per-phase heap trace added in the previous commit only measured
    inside run_cycle(): connect, ntp, post. But POSTs happen every 120 s and
    ble_service::tick() runs at 1 Hz, so roughly 120 ticks fall BETWEEN two
    cycles, entirely outside the instrumented region. A 41 B/POST leak is
    arithmetically indistinguishable from 0.34 B/s of time-based leak, and
    if the source is tick() -- or the sampling task, or the BLE stack -- all
    three existing columns would read ~0 while free heap kept falling. The
    trace would have looked innocent and sent the hunt in the wrong
    direction.
    Record the free heap at the end of each completed cycle and report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
    [wifi_sync.cpp]
2026-09-11 Sync NTP twice a day, and rate-limit failed attempts too
    NTP is a convenience on this device, not the time source of record: the
    RTC holds the clock (+0 s drift measured on the DS3231 build), the
    Android app sets it over BLE, and the ingest response carries
    server_time as a third fallback. Every five minutes was far more than
    the job needs.
    NTP_RESYNC_INTERVAL_SEC 300 -> 43200 (12 h). At that spacing even a
    DS1307's uncompensated drift stays within a couple of seconds, which is
    nothing against a 15-minute log interval. It also cuts configTzTime()
    calls by ~144x, which matters while the heap leak is unattributed --
    it is one of the suspects and a poor thing to leave running 288 times a
    day w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
    [config.h, wifi_sync.cpp]
2026-09-14 Measure the heap where it means something, and retune again
    The first run of the new firmware printed two "free heap" figures that
    differ by ~48 KB every cycle:
    [wifi] heap free=23296 ...
    [heap] cycle: ... free=71636
    Same call, different answers, because the [wifi] line was logged inside
    post_batch while WiFiClientSecure was still in scope. The gap IS the live
    TLS session. So every heap figure quoted from that line all week
    understated real free memory by ~48 KB, and the board that looked to be
    running on 23 KB actually has ~72 KB.
    Scope the client and HTTPClient explicitly so their destructors run
    before the measurement, and report the whole story instead of one
    ambiguous number: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
2026-09-14 Stop calling it leak= when it is not the leak
    The per-POST figure added last commit measured free heap while `resp`
    still held the response body -- post_batch frees that on return -- so it
    overstated the loss by roughly the response size. Across the same four
    cycles it read -618 B average while the clean per-cycle figure moved
    -419 B, the ~200 B gap being exactly the response buffer.
    Rename it dpost, print resp= beside it so the offset can be subtracted
    by eye, and say plainly in the comment that net= on the [heap] cycle
    line is the authoritative rate: that one is taken with every local
    destroyed at both ends. These stay useful for the breakdown of where
    inside a POST the memory goes, and f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
    [wifi_sync.cpp]
2026-09-14 Bisect the POST itself: six stages that must sum to dpost
    The cycle trace narrowed the leak to the post phase (idle positive,
    connect and ntp flat at zero, post consistently negative across two
    runs). This names the individual call.
    Free heap is now read after each stage of the transaction and reported
    as deltas that sum exactly to dpost:
    [wifi] bisect ctor=+0 begin=-1204 post=-46000 read=-160 end=+120 dtor=+46500
    ctor construct WiFiClientSecure + HTTPClient
    begin http.begin() and the two addHeader() calls
    post TCP connect + TLS handshake + request send
    read getString() pulling the body into resp
    end http.end()
    dtor both destructors as the scope closes
    A clean t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
    [config.h, wifi_sync.cpp]
2026-09-14 Backend: store the heap telemetry and push the maintenance config
    The firmware has been sending heap_free / heap_largest / heap_min on
    every POST and parsing nightly_reboot_* / radio_rest_* out of the
    response, but nothing on the server stored the first or emitted the
    second -- the fields went into a void and the config could not be set
    from anywhere. This is the missing half.
    migrations/007 (and schema.sql, kept in step for fresh installs):
    - device_heap_log, a time series rather than three columns, because only
    the trend separates the two failure modes: heap_free falling steadily
    is a leak, heap_free flat while heap_largest decays is fragmentation.
    boot_id and uptime_sec ride along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
    [config.h]
2026-09-14 Admin: put every editable device setting on one line
    The maintenance block landed as its own row above the interval control,
    so the two rows of editable fields were separated by nothing meaningful
    and the card read as three bands of similar-looking inputs.
    Merge them: one dev-cfg line now carries Interval, Nightly reboot, From,
    To, Radio rest and Rest for, with each of the two Set buttons beside the
    fields it saves -- interval is stored and pushed independently of the
    maintenance block, so it keeps its own. The line below is now purely
    read-only telemetry (last sync, FW, RTC drift, Wi-Fi, heap, coin cell,
    rows).
    .dev-line was already flex with wrap, so the merged row reflows to a
    second li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
2026-09-14 Carry heap telemetry over the BLE relay sync too
    The Wi-Fi path only reports heap on a SUCCESSFUL POST, which leaves it
    silent in exactly the case worth understanding: a device that cannot
    reach the server reports nothing about why it cannot. The last sample
    ever received is from before the problem started.
    The BLE relay sync works when Wi-Fi does not -- that is how 108 rows
    came off solar-475b78 while its own POSTs were failing -- so it is the
    one path that can carry a sample out of the failing state.
    uptime_sec and current_boot_id were already on the Device Info
    characteristic and already flowed through to ingest; only heap was
    missing. Added end to end:
    firmware build_device_info_js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
    [ble_service.cpp]
2026-09-15 Add migration 008, and set the heap floor from 618 real samples
    Two fixes from the first real device_heap_log dump.
    1. migration 008 adds device_heap_log.source.
    The dump shows the table was created from 007 as originally written,
    before the BLE-relay change added that column. ingest.php now INSERTs
    it, and against a table without it the INSERT throws -- silently,
    because heap logging is deliberately wrapped in try/catch so
    telemetry can never fail a sync. Heap logging would simply have
    stopped, with nothing in the log to say why. This is a breakage
    introduced by that commit and 008 is required to deploy it.
    2. HEAP_MIN_FREE_BYTES 55000 -> 62000.
    free minus min, a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
    [config.h]
2026-09-15 Enable the heap-floor reboot, on the evidence it was waiting for
    HEAP_LOW_REBOOT_CYCLES 0 -> 3. The comment sitting on that macro asked
    for a few days of real data before acting; 618 samples off solar-2e5694
    supplied it.
    The leak is steady at 35.2 B per POST with heap_largest pinned at 47092
    for a whole 10-hour boot -- a leak, not the fragmentation originally
    theorised. Boot 36 ended 2136 B above the floor with a low-water mark of
    2452 B. The nightly reboot beat exhaustion by roughly two hours, which
    is luck rather than margin.
    Non-zero also re-enables deferring the POST while the heap is low. That
    is deliberate and the two belong together: deferring is only safe
    because this reboot can re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
    [config.h]
2026-09-18 Dashboard: 6am-7pm today axis, true 12am-12am Today, per-bar meter readings
    Three changes to how the dashboard reports generation:
    1. Today's hourly chart now spans 06:00-19:00 instead of 07:00-19:00, so
    the early-morning bar is no longer clipped off the left edge. This
    matches the report page's default solar window (SOLAR_START_DEFAULT).
    2. The "Today" card is now the energy generated between midnight and the
    next midnight: one MAX-MIN of the cumulative meter counter over that
    window, requested with an explicit `to`. It no longer adds the old
    meter's baseline (capacity_kw), which was making the card read as a
    lifetime total (~21122 kWh) rather than the day's generation.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
2026-09-24 Period total is the period's difference; meter reading gets its own card
    Period total was the old-meter baseline plus the window's generation, so
    every range read about the same ~21,000 kWh (Today 21116.98, 24h 21118.13,
    7 days 21196.77, 30 days 21326.85) and the actual difference was buried in
    the decimals. It now shows only what the meter generated inside the
    selected range — end reading minus start reading — so the five ranges read
    1.58 / 5.4 / 71.6 / 286.6 and so on.
    The cumulative figure is not lost: a new "Meter reading" card carries it,
    and it is the same number whatever range is selected. readings.php returns
    meter_wh / meter_at for it — the device's newest reading and its tim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
2026-09-24 Replace the 24 h range with a From-To filter; drop the Today card
    The 24 h button is gone and the controls bar now carries From and To date
    pickers with an Apply button. A custom range picks its bucket size from the
    span — hourly for a day or two, daily up to a quarter, monthly beyond — so
    it is drawn like the fixed range of the same length, and the readings query
    gets an explicit `to` for the first time. The pickers default to the last
    week, won't point past today, and Enter applies the range instead of
    submitting the form. Half-filled or reversed dates say so and leave the
    current view alone.
    Under the energy chart: "Meter reading: 8,984.85 -> 8,990.86 kWh (6.01
    kWh)" — the reading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
2026-09-24 Open the date filter only on Custom; keep the report's From/To together
    The dashboard's From/To pickers sat in the controls bar permanently. They
    are now behind a "Custom" button in the range row and start hidden:
    Custom reveals them (and focuses From) without touching the chart, Apply
    loads the range, and picking any fixed range puts them away again. Custom
    stays lit while a custom range is on screen, so the active range is still
    readable at a glance.
    On the reports page the From and To hour pickers inherited the controls
    bar's 220px select width, which pushed To onto a line of its own, away
    from its label partner. They are now one group with its own spacing and a
    150px width, so they sit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
2026-09-24 Give "Last sync" a line of its own in the controls bar
    It sat inline after the range buttons, crowding them, and moved around when
    the custom date filter opened. Making it a full-width flex item drops it
    onto its own row whatever precedes it, so it reads the same with the filter
    open or closed and at every width.
    Claude-Session: https://claude.ai/code/session_01XBpgpCQzz3bjPrYr8r7pK3
2026-10-03 Backend: counter resets, CSRF, device takeover, admin fixes, dashboard fixes
    From the code review (items 3-10, 15, 19-21; the firmware and app halves of
    2, 11-14 and 16-18 follow separately).
    Data correctness
    - PZEM counter resets no longer break totals (#4). The counter restarts at 0
    on the app's Reset PZEM command or a PZEM swap and rolls over at 9,999.99
    kWh; every total was a MAX-MIN across that drop. ingest.php now records each
    drop between seq-adjacent readings in energy_resets (migration 009), and
    readings.php adds it back onto every later reading, so bars, Period total,
    the readings table and the Meter reading card run on one unbroken counter.
    Pre-009 data is scanned onc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
2026-10-03 Firmware 1.1.0 + app: zero rows, row timestamps, safer sync and resets
    The device and phone halves of the code-review fixes (items 2, 11-14,
    16-18, 22, plus the app side of 3). Applied identically to all three
    firmware variants; they share this code.
    Firmware
    - A failed PZEM read is never logged (#2). classify() reports PZEM_OK for
    the first failures, so `ok || st == PZEM_OK` wrote a row of zeros whenever
    a read failed at the moment a row was due; 0 Wh then became that day's
    first reading on the server. The row is now retried on the next tick.
    - Rows carry the RTC/NTP epoch they were logged at (row format v3, JSON `t`)
    so the server can place rows from an earlier boot exactly; the b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
    [ble_service.cpp, config.h, health.cpp, health.h, solar_monitor_SSD1306_ds1307.ino]
2026-10-03 Drop compatibility with firmware 1.0.0
    No 1.0.0 device is live, so the paths that only existed to accept it go.
    - Firmware: a /log.csv row is exactly ten fields
    (seq,boot_id,sec,V,I,P,Wh,PF,Hz,epoch). The 8- and 9-field formats are no
    longer parsed.
    - App: the BLE relay accepts only ten-field rows, Hz is required, and the
    heap fields in Device Info are required (firmware always sends them).
    - ingest.php: no special case for all-zero rows; only firmware 1.0.0 logged
    them. Migration 009 still deletes the ones already in the database.
    - Dashboard / reports: no fallback for a server without total_kwh; they are
    deployed together.
    Verified again: all three firmware variants build with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
2026-10-03 Line a restarted seq counter up with the server instead of dropping rows
    (device_id, seq) is unique and ingest.php ignores duplicates so re-sent
    batches are harmless. A device whose counter restarted at 1 - full flash
    erase, factory reset, a new board under the same device_id - therefore had
    every new row silently dropped AND acked (so deleted on the device) until its
    counter passed the old maximum.
    - Firmware: when NVS has no saved counter at boot, the device marks itself
    seq_fresh (kept in NVS) and says so in every POST and in BLE Device Info.
    On "seq_base_required" it adds the server's maximum seq to every buffered
    row and to its counter, clears the flag and resends at once. The ap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
    [ble_service.cpp, solar_monitor_SSD1306_ds1307.ino, solar_monitor_SSD1306_ds3231.ino, solar_monitor_ds1307.ino]
2026-10-03 Add the test suites and a testing guide
    The checks used to verify today's changes, moved into the repo so they can
    be re-run, plus a manual checklist for the real server, devices and app.
    tests/run_all.sh runs everything:
    - backend/run.sh: a throwaway MariaDB built from schema.sql and PHP's
    built-in server; 48 API checks (ingest, counter resets, PZEM swap, row
    timestamps, seq renumbering, CSRF, claiming, admin, time zone) and 12
    browser checks on the dashboard (playwright; skipped if absent).
    - firmware/run.sh: the firmware's date maths, ISO parsing and row
    parse/format/renumber, extracted from each variant's source and run on the
    host.
    - android/run.sh: the app's real DeviceSynce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
2026-10-03 Fix the app build: keep onProgress the last syncConnected parameter
    afterSeqBase was added after onProgress, so DeviceDetailViewModel's
    trailing `{ p -> ... }` bound to the Boolean instead and the app no longer
    compiled. It now sits before onProgress.
    The JVM tests compile DeviceSyncer but not the ViewModel, so they missed it;
    a new test calls syncConnected with a trailing lambda exactly as the
    ViewModel does, and fails to compile if this regresses.
    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
2026-10-03 DeviceDetailViewModel: clear the IDE warnings
    - Drop the unused ViewModelProvider import.
    - withTimeout / delay take Durations (20.seconds, 15.seconds,
    1500.milliseconds) instead of the legacy Long overloads; same values.
    - Remove disconnect() and clearCommandMessage(), which nothing calls.
    - The sync error handler is one catch that branches on NotConnectedException,
    so no catch parameter goes unused.
    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
2026-10-03 BleScanner: drop an empty if, and describe what the scan really matches
    The if around "Service-UUID match is enough" had an empty body; the
    placeholder name it talks about is built on the next line anyway. Its
    comment now sits there.
    The class comment claimed a fallback that accepts devices by their "Solar-"
    name when an advert lacks the service UUID. There is none: the ScanFilter
    matches on the service UUID, so Android never delivers anything else. The
    comment now says that. No behaviour change.
    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
2026-10-03 Android app: upgrade the toolchain and clear the IDE/Lint warnings
    Toolchain
    - AGP 8.7.3 -> 9.3.2 with built-in Kotlin: the kotlin-android plugin is
    gone, jvmTarget follows compileOptions, and the Kotlin Gradle plugin is
    pinned through the root buildscript classpath.
    - Kotlin 2.1.0 -> 2.4.20, Gradle wrapper 9.7.1 added (checksum-pinned),
    compileSdk/targetSdk 35 -> 37. Kotlin 2.4.20 is tested up to AGP 9.3 and
    Gradle 9.7. Needs Android Studio Quail 2 (2026.1.2) or newer.
    - Compose BOM 2026.09.00, core 1.19.1, lifecycle 2.11.0, activity 1.13.0,
    navigation 2.10.2, datastore 1.2.1, coroutines 1.11.0, serialization
    1.11.0, Ktor 3.6.0, Kable 0.45.0, Vico 3.3.1. Unused ktor-client-loggi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
2026-10-03 Android: observable locale in the dashboard, drop empty super.onCleared()
    - CloudDashboardScreen formatted numbers with Locale.getDefault(), which a
    composable can't observe (Compose Lint NonObservableLocale, severity
    error). Use LocalLocale.current.platformLocale, as the check recommends,
    so the stat cards re-format when the user changes language.
    - ViewModel.onCleared() is empty; MainViewModel and DeviceDetailViewModel
    no longer call super.
    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
2026-10-18 Fix BLE sync losing rows: firmware 1.1.1 stream, app acks only whole dumps
    The firmware streamed its buffer with setValue() + notify(). In NimBLE 2.x
    that notify() only flags the characteristic; the host task later sends
    whatever the value is by then, so back-to-back chunks collapsed into one
    and rows went missing while END still arrived. The app then acked the
    highest seq it saw and the device deleted rows the phone never received;
    in the reported case a sync moved just one row per tap.
    Firmware 1.1.1 (all three variants):
    - each piece is passed to notify(value, len, connHandle), which queues
    that exact value and reports a full TX pool; the pump waits and
    retries, and abandons the dump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
2026-10-24 Sync now: read every device instead of trusting its unsynced_count
    The all-devices "Sync now" skipped any device reporting unsynced_count 0
    without reading its data stream; the device screen's Sync read it anyway.
    A device reporting 0 with rows still buffered was therefore "up to date"
    for Sync now while its own Sync button (labelled "Sync (heartbeat)")
    uploaded the rows. Both now run the identical path: the shortcut and its
    trustUnsyncedCount parameter are gone, and an idle device costs one short
    stream subscription. The device-screen button reads "Sync now" when the
    count is 0, since the count can be wrong.
    tests/android: 16 tests (rows synced despite a 0 count; idle device read
    once and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
2026-10-24 Firmware 1.1.2: stuck-Wi-Fi watchdog no longer fires on an idle buffer
    The watchdog counted every second spent associated without a successful
    POST. With an empty buffer the device has nothing to POST until the next
    row (log interval, 900 s by default) or the hourly heartbeat, so about
    600 s after each upload it logged "stuck-wifi: associated but no POST for
    600 s", forced a 45 s radio rest (Wi-Fi and BLE off-air) and reassociated:
    every 15 minutes on a perfectly healthy link.
    The counter now advances only while associated AND rows are waiting
    (unsynced_count > 0). Rows waiting are POSTed on the next cycle (every
    120 s), so 600 s of that without a POST landing is ~5 failed cycles, a
    real fa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
2026-10-24 Firmware: clearer log when NTP sets a stopped RTC
    With the DS1307 oscillator halted the RTC reads 0, and the writeback log
    printed the whole epoch as "drift" (drift=1792831696 sec). No drift sample
    is taken in that case (rtc_now > 0 is required), so only the message was
    misleading; it now says "RTC was not running - set from NTP".
    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
2026-10-24 Firmware 1.1.3: trace the PZEM on serial
    The PZEM was read every second with nothing on serial, so a dead or
    miswired meter only showed as rows no longer arriving. Now:
    - boot: "[pzem] ok: 231.5 V, 1.20 A, 250 W, 21974.05 kWh, 50.0 Hz, PF
    0.99" with the first good reading;
    - then one line per change of state, following the existing classify():
    "[pzem] no response - check RX/TX wiring and the 5 V supply" after 3
    failed reads, "[pzem] sensor fault: 0.0 V - check the AC voltage input"
    after 60 s under 50 V, "[pzem] back: ..." on recovery. No line per
    second, and a one- or two-read blip stays silent;
    - INFO also prints the PZEM state and its last reading.
    All three variants. The trace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
2026-10-26 Keep cloud sign-ins alive, and never sync without one
    Root cause: the server's PHP sessions were stored in the host's shared
    session folder, where cPanel's cleanup deletes them after php.ini's 24 min
    of idleness, whatever SESSION_LIFETIME (8 h) says. So the app's sign-in
    died ~half an hour after it was last used, and Sync now connected and
    streamed each device only to have the upload refused ("Sign in on the
    Cloud tab first"), then moved on to the next device.
    Server (_db.php): sessions now live in a private folder next to
    secrets.php, outside the web root, with gc_maxlifetime = SESSION_LIFETIME
    and PHP's own garbage collection. Skipped (host default kept) if the
    secrets file is under the w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
2026-10-26 App Cloud tab: lay out and compute like the web dashboard
    The app still had the old dashboard: a 24 h range, "Period kWh" with the
    old-meter baseline added in (21,130.66 where the web shows 15.26), no
    meter reading, no readings table, and charts that scrolled sideways.
    Now, matching backend/public_html/dashboard/index.php:
    - Ranges Today / 7 days / 30 days / 12 months / Custom, with the same
    windows (whole days from local midnight, 12 months from the 1st,
    Today 06:00-19:00 on the X axis). Custom opens a From/To filter
    (date pickers, no future dates) and loads on Apply; the bucket size
    follows the span as on the web.
    - "Last sync: <time> (x min ago)" on its own line, ticking.
    - Cards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
2026-10-26 App Cloud tab: fix the crash when data loads (blank chart label)
    Vico 3 throws IllegalStateException if an axis CartesianValueFormatter
    returns a blank string ("Use HorizontalAxis.ItemPlacer ... not blank
    strings"), and it formats more x values than the visible labels: it
    measures label widths at in-between values. The Power chart on Today
    returned "" for every non-whole-hour minute to hide those labels, so the
    first draw with data (right after sign-in) crashed the app; the index
    formatters could also return "" for a missing label.
    Formatters now always return text: the raw power axis formats any minute
    as its hour (the item placer still puts labels on whole hours only), and
    bar labels fall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
2026-10-26 Android: modern brand theme and restyled Cloud dashboard
    Theme: a full Material 3 scheme in the web dashboard's green, with amber as
    the tertiary accent, for both light and dark mode. It sets every role,
    including the surfaceContainer ones, and adds rounder shapes and bolder
    titles. Wallpaper dynamic colour is gone, so the app looks the same on
    every phone.
    Cloud dashboard:
    - Header with a tonal sign-out button.
    - Range picker is a segmented control, with Custom as a chip.
    - Stat tiles in their own tonal colours, with icon badges.
    - Rounded primary bars on the energy chart; the power line uses the amber
    accent and fades out underneath.
    - Meter span shown as a pill.
    - Readings table has a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
2026-10-28 App Cloud tab: reload after a sync; energy, power, then readings
    The Cloud tab kept the data it fetched at app start until the app was
    restarted. It now reloads the device list (Last sync) and the current range:
    - after every sync that gets rows to the server. DeviceSyncer announces each
    upload, and both "Sync now" and a device's own Sync go through it;
    - when the tab is shown (tab switch, or the app back in front) if the last
    load is more than 20 s old, which picks up rows a device sent over Wi-Fi;
    - on pull-to-refresh.
    Sections now run energy chart, power chart, then meter readings per bar, in
    the same order as the web dashboard.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
2026-10-28 Web dashboard: brand theme matching the app; energy, power, then readings
    All pages share the app's Material 3 colours (green primary, amber power
    accent, tonal surfaces) and follow the device's light / dark setting:
    - header with a logo and pill navigation;
    - segmented range control with a Custom range chip;
    - tonal stat tiles with icons;
    - rounded cards with section icons;
    - fixed-height charts (rounded green bars, amber power line with a fade)
    that redraw on a light / dark switch;
    - a tinted readings table.
    The admin, sign-in and setup pages use the same theme. Icons are inline SVG
    (api/_ui.php) and Chart.js styling comes from the CSS tokens
    (dashboard/assets/theme.js). Stylesheet vers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
